StarryReverie/board/ppt/assets/下板终端日志.jpg

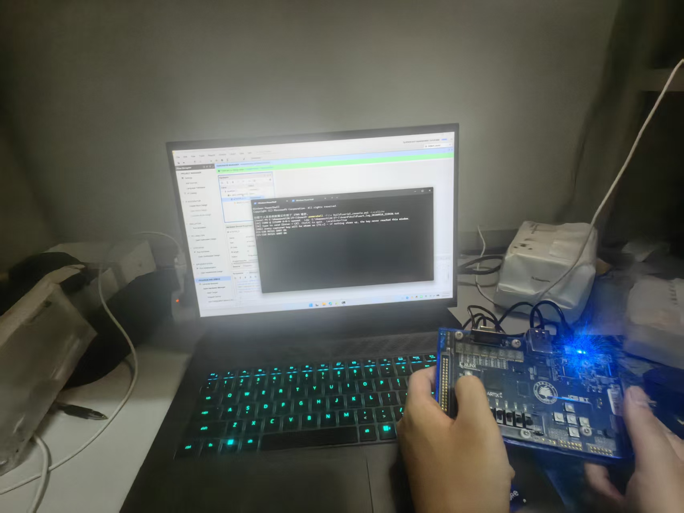
ppt/assets/下板终端日志.jpg
