StarryReverie/board/README.md

# board — 计算机组成原理 + 汇编与接口 课程设计

## 目录结构

```text
board/
 ├─ pipeline/            计组实验一（本仓主干，统一代码目录）
 │   ├─ src/rtl/          流水线 CPU core RTL（14 模块，含 pipeline_top）+ 上板顶层 exp1_board_top/exp1_reset_sync
 │   ├─ src/defines/      指令/常量宏
 │   ├─ src/test/         TB + 汇编测试程序（.asm/.hex + 上板固化镜像 _init.vh）
 │   ├─ src/scripts/      run_tb.ps1（批量仿真）、run_perf.ps1（性能测量）、build_asm.ps1（汇编→hex）、fix_encoding.ps1（编码校验）、synth_check.tcl（综合自检）、hex_to_vh.ps1（hex→固化镜像）、create_exp1_board_proj.tcl（上板工程）
 │   ├─ xdc/              实验一独立上板引脚约束（board_exp1.xdc）
 │   ├─ doc/              计组设计文档（isa/top_design/tasks/modules/future_extensions/perf_analysis 性能分析方案 v2.1/perf_report 实测数据/board_runbook 上板手册）
 │   └─ exp1_vivado.bat   exp1 Vivado 工程入口
 ├─ UART/                汇编与接口课程（交付物：UART 控制器 IP——uart_ip_top + 内部层 + IP 级独立测试）
 ├─ soc/                 整个项目的顶层（SoC 集成，两课共建：soc_top/reset_sync/dbus_decode + 固件/XDC/系统 TB）
 ├─ SUBMISSION.md        两门课提交物核对清单（9/18 24:00 截止）
 ├─ ref/CPU/             大三单周期参考工程（只读）
 └─ tools/(仓库外)        RISC-V 工具链（E:\Homework\26-27-1\tools）
```

## 快速上手（本机 Vivado 2019.2 + xPack RISC-V 工具链）

```powershell
# 仿真全部单测/回归（23 项，须在装有 Vivado 的机器）
powershell -File pipeline/src/scripts/run_tb.ps1          # 全部
powershell -File pipeline/src/scripts/run_tb.ps1 -Case alu # 按名过滤

# 汇编测试程序 → 机器码镜像
powershell -File pipeline/src/scripts/build_asm.ps1

# 性能测量（8 档程序：CPI/IPC/停顿分解，汇总 out/perf_summary.csv）
powershell -File pipeline/src/scripts/run_perf.ps1

# Vivado 综合自检（include 目录 = pipeline/src/）
vivado -mode batch -source pipeline/src/scripts/synth_check.tcl

# 文本编码健康校验（全仓 UTF-8；默认仅报告，-Apply 写回）
powershell -File pipeline/src/scripts/fix_encoding.ps1
```

## 实验一独立上板（CPU core 单独上板，不接 UART）

```powershell
# ① 汇编上板验收程序 → .hex
uv run --no-project --python 3.13.13 pipeline/src/scripts/simple_asm.py pipeline/src/test/exp1_board_demo.asm
# ② .hex → 综合固化镜像 <名>_init.vh（含回读逐字节校验）
powershell -File pipeline/src/scripts/hex_to_vh.ps1 -Hex pipeline/src/test/exp1_board_demo_rom.hex -PadBytes 512
# ③ 生成独立上板工程（pipeline/vivado/board_exp1.xpr，512B IMEM / 256B DMEM）
vivado -mode batch -source pipeline/src/scripts/create_exp1_board_proj.tcl
```

完整步骤（综合/烧录/验收判据/拍摄/故障定位）见 **`pipeline/doc/board_runbook.md`**；
板级顶层为 `exp1_board_top`（LED 状态灯 + 8 位数码管显示验收签名 `0000000F`），
引脚约束 `pipeline/xdc/board_exp1.xdc`（依 EES-338 用户手册 §6.3/§6.4）。

## 下板（SoC U32：本机已可全流程出 bit+烧录；完整方案见 soc/doc/board_runbook.md）

> 2026-09-15：SoC 建工程改为**一条命令**——`vivado -mode batch -source soc/scripts/create_soc_proj.tcl`（工程 `soc/vivado/soc.xpr`，bit 产物 `soc/vivado/soc.runs/impl_1/soc_top.bit`）；固件构建脚本保留 `UART/src/scripts/build_fw.ps1`（综合自检 `UART/src/scripts/synth_check.tcl`）；烧录/取证脚本仍为手动步骤或从 git 历史恢复。完整口径见 `soc/doc/board_runbook.md` §1（**part 必须用实测 `xc7a100tcsg324-1`**，用户手册误标 35T）。

# Vivado GUI（工程已按工程风格分组，可直接打开）
```text
双击 pipeline/vivado/board.xpr（exp1 工程，目录 = pipeline/vivado；若不存在，先执行下方重建命令）
  设计源 sources_1 : pipeline/src/rtl/*.v          top = pipeline_top（综合/实现）
  仿真源 sim_1     : pipeline/src/test/tb_*.v      top = tb_pipeline_top（默认）
  约束  constrs_1  : （实验一为空；SoC XDC 在 soc/xdc/board.xdc）
  include 目录     : pipeline/src/（VerilogDir=$PPRDIR/../src，`include "defines/…" 由此解析）
soc（SoC 集成）工程：`soc/scripts/create_soc_proj.tcl` 一条命令生成（见 soc/doc/board_runbook.md §1）；UART（UART IP）单独建工程时只需读入 UART/src/rtl/*.v，top=uart_ip_top（也可用 UART/src/scripts/synth_check.tcl 做不落盘的综合自检）。
```
重建工程（工程不入 git，本机生成即可）：
```powershell
vivado -mode batch -source pipeline/src/scripts/create_vivado_proj.tcl   # 实验一 流水线 CPU → pipeline/vivado/board.xpr
vivado -mode batch -source soc/scripts/create_soc_proj.tcl              # 实验二 SoC → soc/vivado/soc.xpr
```

辅助脚本（演示 / 验证，均在仓库内、产物落 `build/`）：
```powershell
# 实验二：串口终端（视频演示用；只打印 FPGA 回传的字节，等价 Local echo 关闭）
powershell -File soc/scripts/serial_console.ps1 -Log build\uart_soc_terminal_YYYYMMDD.log
powershell -File soc/scripts/run_soc_tb.ps1               # SoC/UART 侧 TB（3 项；-All 全跑）
# 实验一：逐拍 trace / 变异与 ALU 故障矩阵（证据脚本）
powershell -File pipeline/src/scripts/run_trace_bd.ps1
powershell -File pipeline/src/scripts/run_mut.ps1
powershell -File pipeline/src/scripts/run_mut_alu.ps1
```
用法与操作卡见 `soc/doc/board_runbook.md` §10 与 `pipeline/doc/board_runbook.md` §8。

> 说明：RTL 内 `` `include "defines/*.v"`` 以 **pipeline/src/ 为 include 目录**解析；Vivado
> 工程中把 include 目录指向 `pipeline/src/` 即可直接读入 `pipeline/src/rtl/` 全部源码。
> 程序级回归 TB（tb_prog_*）经 $readmemh 按文件名读 .hex，GUI 直跑需把
> `pipeline/src/test/*.hex` 复制到 xsim 工作目录；**推荐用 run_tb.ps1 跑仿真**（自动拷贝）。
