StarryReverie/board/pipeline/doc/top_design.md

# 计算机系统顶层设计（实验一：流水线 CPU core · 实验二：UART 集成 SoC）

- 版本：v1.7（2026-09-07：uart_ctrl 寄存器层并入 uart_ip_top——单模块 UART IP，功能/契约零改动；对齐 UART interface v1.3）。
- 布局：代码目录统一于 `pipeline/src/`（RTL `*.v` 于 `pipeline/src/rtl/`、宏 `pipeline/src/defines/`、汇编/测试 `pipeline/src/test/`、工具 `pipeline/src/scripts/`）；文档 `pipeline/doc/`；汇编实验独立于 `UART/`；`ref/CPU/` 不改动。指令集：`pipeline/doc/isa.md`（26 条 RV32I，统一编址 MMIO 不加指令）；参考：`pipeline/doc/ref_note.md`。

---

## 0. 项目两级结构、模块清单与分工

> 本文档覆盖两门课程设计：**实验一**＝RV32I 5 级流水线 **CPU core**（`pipeline_top`，§1–§8，门禁 M1–M3，见 tasks.md §2–§5）；**实验二**＝在其上集成全双工 UART 形成**整机 SoC**（§9，见 tasks.md §6 T40–T44）。实验一单独交付时 core 的 `dbus_decode` 与 `imem` 写口不启用（恒 0/不例化），§1–§8 完全成立。

### 0.1 两级结构（总图）

```
【实验一】CPU core = pipeline_top（§1–§8，交付物）
   取指 IF ──► 译码 ID ──► 执行 EX ──► 访存 MEM ──► 回写 WB ──► regfile
   段间寄存器：if_id · id_ex · ex_mem · mem_wb（各带 en/flush）；冒险：hazard_unit 前递/冻结/冲刷

   实验一存储接法 = 直连（无译码、无写口）：
     取指侧  pc ──► imem 读口 ──► inst ──► IF/ID
     访存侧  ex_mem ──► dmem ──► mem_wb        （取指/访存分体 → 哈佛，互不冲突）

【实验二】SoC 整机 = soc_top（§9）＝ 实验一 core ＋ 数据侧统一编址译码 ＋ UART 外围（程序固化模型）
   ① 取指侧：程序 .vh 初值固化于 imem，上电自跑 0x0（每次启动执行同一程序）；imem 写口为预留（恒 0）
     运行：   pc ──► imem(读口) ──► inst ──► IF/ID          ← core 取指（固定程序）
     换程序： 重新生成 .vh → 重新综合 → 重烧 .bit（JTAG/SPI-Flash）；不做运行期在线重载（loader 搁置）

   ② 访存侧：MEM 段插 dbus_decode 选路 —— CPU 不再直连 dmem/uart（统一编址 MMIO，方案 B：lw=读 in/r、sw=写 out/w）
     ex_mem(addr/wdata/we) ──► dbus_decode ──┬─ 低区 cs_dmem ──► dmem 数据 RAM
                                              └─ MMIO cs_mmio ──► uart_ip_top（TX/STAT/RX 字槽）
     读回：  mem_wb ◄── rdata ◄── dbus_decode（dmem/uart 二选一 mux）
     外发：  uart_ip_top（寄存器层 + uart_tx/uart_rx，全双工）──► USB-UART ──► PC

   复位（§9.5）：板载复位键 ──► reset_sync ──► rst(异步高有效) ──► core（单时钟域 clk）
```

- **实验一（core）**：上图的"CPU core"即 `pipeline_top`＝5 段哈佛流水，交付可综合 CPU core，H1–H5 全绿（门禁 M1–M3，tasks.md §2–§5）。
- **实验二（SoC）**：`soc_top`＝`pipeline_top`（数据侧含 `dbus_decode` 统一编址译码）＋ `uart_ip_top`（实验二 UART 控制器 **IP 顶层**，寄存器层已并入，单模块交付）＋ `reset_sync`（上板复位）。程序经 `.vh` 固化于 imem：上电自跑固定固件 console（§9.6，banner+回显）；换程序＝重新生成 `.vh` → 重新综合 → 重烧（§9.3）。

### 0.2 模块清单（RTL 归属 ↔ 文档）

| 归属 | 模块 | 段/角色 | 模块文档 |
|---|---|---|---|
| 实验一 | `pc_reg` / `imem` | IF：取指/指令存储 | modules/{pc_reg,imem}.md |
| 实验一 | `if_id` / `decode`+`regfile` / `id_ex` | ID | modules/{if_id,decode,regfile,id_ex}.md |
| 实验一 | `execute`（含 `alu`） | EX | modules/{execute,alu}.md |
| 实验一 | `ex_mem` / `dmem` / `mem_wb` / `wb` | MEM/WB | modules/{ex_mem,dmem,mem_wb,wb}.md |
| 实验一 | `hazard_unit` / `pipeline_top` | 冒险 / 装配 | modules/{hazard_unit,pipeline_top}.md |
| 实验二 | `dbus_decode` | core 数据侧译码（统一编址，入 pipeline_top MEM 段） | modules/dbus_decode.md |
| 实验二 | `uart_ip_top` | UART 控制器 **IP 顶层**（实验二交付物；寄存器层已并入，内部例化 `uart_tx`/`uart_rx`） | [uart_ip_top.md](../../UART/doc/modules/uart_ip_top.md) |
| 实验二 | `loader`（**搁置**） | imem 引导装载（固化单程序模型下不做；恢复条件见 future_extensions §1/§2） | 实验二登记（取消） |
| 项目顶层（soc/） | `soc_top`（含 `reset_sync`） | 整机例化 / 复位同步 | [soc_top.md](../../soc/doc/modules/soc_top.md) |

---

## 1. 总体结构：5 段 × (组合逻辑 + 段间寄存器)

一条指令沿 5 级流过，每级 = 一段组合逻辑，段间由寄存器锁存结果（§0.1 总图中的 CPU core）：

```
 取指 ─► if_id ─► 译码 ─► id_ex ─► 执行 ─► ex_mem ─► 访存 ─► mem_wb ─► 回写
  IF               ID               EX               MEM               WB
```

| 段 | 组合逻辑 | 边界寄存器（本段结束沿锁存） |
|---|---|---|
| IF 取指 | `pc_reg`、`imem`（组合读） | `if_id` |
| ID 译码 | `decode` + `regfile`（读口） | `id_ex` |
| EX 执行 | `execute`（含 `alu`、分支目标加法） | `ex_mem` |
| MEM 访存 | `dmem`（组合读/同步写） | `mem_wb` |
| WB 回写 | `wb`（选 rdata/alu 回写） | —（写回 `regfile`） |

- 段间 4 组边界寄存器由 `hazard_unit` 统一驱动：前递 `fwd_a/b_sel`、load-use 冻结 `stall`、分支冲刷 `flush`（策略见 §4）。
- 哈佛：IMEM（指令）与 DMEM（数据）物理分离 → 结构冒险靠分离化解（报告口径）。
- 模块互连信号全表见 §5；实验二在 MEM 段数据侧插入 `dbus_decode`（统一编址 MMIO，§9.2）；程序 `.vh` 固化于 imem、写口预留（§9.3）。

## 2. 段间寄存器边界与字段（字段名即跨模块信号名）

| 寄存器 | 位置 | 字段 | 说明 |
|---|---|---|---|
| if_id | IF/ID 间 | `ifid_inst[31:0]`, `ifid_pc[31:0]` | 冻结：`en=0`；冲刷：置 NOP `0x13` |
| id_ex | ID/EX 间 | `idex_pc, idex_rs1_data, idex_rs2_data, idex_imm, idex_rs1, idex_rs2, idex_rd`；`ctrl`：`alu_op[3:0], src_a[1:0], src_b[1:0], mem_read, mem_write, mem_to_reg, reg_write, jump[1:0], bne` | 冲刷/气泡：`ctrl` 全 0（NOP） |
| ex_mem | EX/MEM 间 | `exmem_alu_result, exmem_wdata, exmem_rd`；`mem_read, mem_write, mem_to_reg, reg_write` | 常规打入 |
| mem_wb | MEM/WB 间 | `memwb_rdata, memwb_alu_result, memwb_rd`；`mem_to_reg, reg_write` | 常规打入 |

控制组说明：
- `alu_op[3:0]`=`ALU_*`（`const_define.v`）；`jump[1:0]`=`0`无/`1`分支/`2`jal/`3`jalr；`bne`=1 表示 bne。
- `src_a[1:0]`：A 源 `0=rs1_fwd/1=idex_pc/2=0`；`src_b[1:0]`：B 源 `0=rs2_fwd/1=imm/2=4`。
- 组合约定：LUI=`src_a=0,src_b=imm,op=OR`(0|imm 直通)；jal/jalr 链接=`pc+4` 写 rd。
- 译码真值表见 `modules/decode.md`；字段全表见各模块文档。

## 3. 取指 / 分支 / 跳转语义（EX 段判决）

| 指令类 | ALU | ALU 结果用途 | 目标 | 条件 |
|---|---|---|---|---|
| beq/bne | src_a=rs1, src_b=rs2, op=SUB | 置 `zero` | `target = pc + imm`（专用加法器，A 选 pc） | taken = `bne? !zero : zero` |
| jal | src_a=pc, src_b=4, op=ADD | 链接 `pc+4` 写 rd | `target = pc + imm`（加法器，A 选 pc） | 恒 taken |
| jalr | src_a=pc, src_b=4, op=ADD | 链接 `pc+4` 写 rd | `target = rs1_fwd + imm`（加法器，A 选 rs1_fwd） | 恒 taken |
| lui | src_a=0, src_b=imm, op=OR | imm 直通写 rd | — | — |
| 普通 ALU | src_a=rs1 | 常规 | — | — |

- 目标加法器：A=`jump==3 ? rs1_fwd : pc`，B=`imm`；`br_target = A+B`（jalr 结果 &~1）。
- **控制冒险**：not-taken 预测。taken → 下一沿冲刷 2 条（IF/ID 置 NOP、ID/EX 控制清零）且 PC←br_target；not-taken 无气泡；EX 指令正常流入 EX/MEM。分支比较值由前递/旁路提供（§5），故仅在真正的 load-use 距离才停 1 拍。

## 4. 冲突（冒险）处理策略 —— hazard_unit

| 冲突 | 手段 | 条件（判定） | 代价 |
|---|---|---|---|
| 数据相关（RAW） | **前递** EX/MEM 与 MEM/WB → EX 的 A/B 源 | EX/MEM 或 MEM/WB 指令 `reg_write && rd≠0` 且 `rd==EX 的 rs1/rs2 地址`；**EX/MEM 为 load(`mem_read`)时不前递**（数据未就绪，靠下方 stall） | 0 |
| load-use | **冻结**：PC 与 IF/ID 停一拍，ID/EX 灌气泡 | ID 指令 rs1/rs2 命中 `idex` 中 load(`mem_read=1`) 的 `rd`（rd≠0） | 恰 1 气泡 |
| 控制相关 | 分支 EX 判决 + taken 冲刷 2 条（§3） | EX 段 taken | 恰 2 条 |
| 结构相关 | IMEM/DMEM 分离 + regfile 2 读 1 写 | 设计上消除 | 0 |

- 前递优先级：EX/MEM（更近）优先，同命中取 EX/MEM；MEM/WB 前递值 = `mem_to_reg ? rdata : alu_result`（已含 jal 链接值）。
- regfile **读旁路（write-first）**：读口命中当拍写口且 `reg_write` 时返回 `wdata`，消除"生产者恰在 WB、消费者同拍在 ID"的陈旧读。
- 控制输出（hazard_unit → 各段）：`fwd_a_sel/fwd_b_sel[1:0]`（`0=reg 1=EX/MEM 2=MEM/WB` → execute）；`stall`（load-use → `pc_reg.en=0, if_id.en=0, id_ex 气泡`）；`flush_branch`（=EX `br_taken` → if_id 冲刷、id_ex 气泡，`pc_src=1`）。
- 冻结与冲刷互斥：EX 段单指令不可能同时是 load 与分支。

## 5. 数据通路信号总览（模块互连）

| 段 | 模块 | 输入（来源） | 输出（去向） |
|---|---|---|---|
| IF | `pc_reg` | clk/rst, en, pc_src, pc_branch(EX) | pc → imem 地址（组合输入）、if_id 的 pc 位 |
| IF | `imem` | 地址=pc（读口） | inst → if_id（.vh 固化；写口预留恒 0，§9.3） |
| ID | `if_id` | en, flush, pc, inst | ifid_pc, ifid_inst → decode |
| ID | `decode`+`regfile` | ifid_inst/ifid_pc, regfile 写回, `idex_mem_read/idex_rd`(load-use) | rs1_data/rs2_data/imm/rd/Ctrl → id_ex |
| EX | `id_ex` | decode 全部输出 + flush/气泡 | → execute、hazard_unit |
| EX | `execute`(alu+目标加法) | idex_*, fwd_a/fwd_b 源值 | alu_result/zero, wdata(rs2_fwd), br_taken/br_target → ex_mem、pc_reg、hazard_unit |
| MEM | `ex_mem` | execute 输出 | → dmem、mem_wb |
| MEM | `dmem` | 地址=exmem_alu_result, wdata=exmem_wdata, we | rdata → mem_wb（实验二经 dbus_decode 选路，§9.2） |
| WB | `mem_wb` | dmem rdata + ex_mem 输出 | → wb |
| WB | `wb` | memwb_* | regfile 写口（经 wb 选路） |

## 6. 存储（Verilog 口径，面向下板）

- `imem`（指令存储）：读口=取指**组合读**；内容在综合期由 `.vh`（`initial` 字面量 `for` 循环）**固化**——上电不接任何装载动作即可直接运行（`pipeline/src/test/*.hex` 仅供 TB `$readmemh`，两路一致性由校验脚本保证）；**loader 写口为预留**（`imem_wen/imem_waddr/imem_wdata`，字 4 对齐同步写，实验一/实验二均恒 0；若未来恢复"运行期换程序"须先回写本文件与 tasks.md，见 future_extensions §1/§2）。字节数组小端 `{mem[a+3],…,mem[a]}`，字地址 4 对齐。
- `dmem`：同步写（wmask 字节使能，默认全字）、组合读（周期内稳定）；字节数组小端。
- 规模：`IMEM_WORDS/DMEM_WORDS`（默认各 1024 字=4KB，测试集 <1KB），综合为分布式 ROM/RAM；块 BRAM 为可选优化（读出寄存器另计一拍）。
- `.vh`/`.hex` 一致且仅含指令清单内指令，由 `verify_hex.py` 校验（tasks.md T31）。

## 7. 时钟/复位

- 单时钟 `clk`；复位 `rst` **异步高有效**（对齐参考 `pc_reg.v/regfile.v` 的 `posedge rst` 写法）：复位 PC=0、流水寄存器与 regfile 清零。每模块单时钟、无门控；段间寄存器 `en/flush` 由 hazard_unit 统一驱动。

## 8. 验收口径（H1–H5）

- H1 直行无依赖链：CPI=1（首条启动流水外），cycle 数=手算。
- H2 前递：`add x1,..;` 紧接用 x1 无气泡，终值=golden。
- H3 load-use：`lw x2,0(x1); add x3,x2,x2` 恰 1 气泡。
- H4 分支：taken 刷 2 条 / not-taken 无气泡，cycle 与手算一致。
- H5 整程序（test0/test1/sort + 新增）与注释预期一致。

## 9. 实验二：SoC 集成设计（整机 = core + dbus_decode + uart_ip_top，程序固化）

> 本节把实验一交付的 CPU core（§1–§8，门禁 M1–M3 全绿后启动）构造成**能与 PC 通信的整机**：数据侧插入 `dbus_decode`（统一编址 MMIO，§9.2）、程序经 `.vh` 固化于 imem 自启动（固化单程序模型，§9.3）、全双工 UART 外设与整机装配（§9.4/§9.5）、固定固件 console（§9.6）、验收（§9.7）。任务见 tasks.md §6（T40–T44）。core 本身不因实验二改动：imem 写口/MMIO 译码实验一恒 0/不例化，H1–H5 口径不变。

### 9.1 架构口径（一句话）

- 执行期**哈佛不变**：IF 直连 `imem` 读口，数据 `lw/sw` 走 MEM 段数据总线。**程序固化模型**：程序镜像在综合期经 `.vh` 初值写入 `imem`，上电复位后 CPU 恒从 `0x0000_0000` 执行同一程序；换程序 = 重新生成 `.vh` → 重新综合 → 重烧 `.bit`（JTAG 下载易失 / SPI-Flash 上电自启）；**不做运行期在线重载**（loader 状态机搁置，见 future_extensions §1/§2）。运行期 `imem` 只读（预留写口恒 0）→ 仍是哈佛（改良哈佛），不是冯·诺依曼。

### 9.2 数据侧译码（dbus_decode：DMEM/MMIO 选路）

- 独立组合模块 **`dbus_decode`**（数据总线译码，模块文档 `pipeline/doc/modules/dbus_decode.md`）。插入位置：`ex_mem` 与 `mem_wb` 之间（实验一 dmem 直连处）。按 `addr=exmem_alu_result` 选从设备并出 `cs_dmem/cs_mmio/reg_off`，回写数据 `rdata` mux。实验一不例化；T40 启用并接 dmem/uart_ip_top。
- 时序对齐：外设读与 dmem 同为周期内组合（沿前稳定）、写与 dmem 同步写同一沿 → 插入译码**不引入新冒险、不改流水级数**。与 hazard 无关（load-use/前递按 rd 判定，不关心命中 RAM 还是外设）。
- 地址映射（**定稿 v1.4；同步冻结于 `isa.md` §4**）：

| 数据地址 | 目标 | 说明 |
|---|---|---|
| `0x0000_0000`–`0x0000_0FFF`（`addr < DMEM_BYTES`，默认 4096） | `dmem` | 数据 RAM（lw/sw） |
| MMIO 窗口 `0x0000_4000`：+0x0 | TX 槽 | 写=待发字节（低 8 位；TX_BUSY=0 时触发发送，忙时写丢弃）；读=0 |
| +0x4 | STAT 槽 | 读：bit0=TX_BUSY、bit1=RX_VALID；写无操作 |
| +0x8 | RX 槽 | 读=收到字节（低 8 位），读后清 RX_VALID；写无操作 |
| 其余 | — | `rdata=0`、写丢弃（程序不应访问，无定义但无害） |

- 编址口径（方案 B 定稿）：**统一编址，不加 in/out 指令**——`lw` 即外设读（in/r）、`sw` 即外设写（out/w），读写方向由指令天然区分；低区/MMIO 窗口由 `addr` 判定，`reg_off[1:0]` 拆槽（00=TX、01=STAT、10=RX、11=保留）。上表即程序可见内存映射。

### 9.3 程序固化与换程序流程（固化单程序模型）

- **固化**：imem 内容 = `verify_hex.py` 生成的 `.vh`（`initial` 字面量，综合装载）；上电复位 PC=0 直接运行固化程序，无需任何装载动作；仿真侧由 TB `$readmemh` 装载同内容 `.hex`（两路一致性由校验脚本保证）。
- **换程序**：改 `pipeline/src/test/*.asm` → `make` 出 `.hex/.vh` → 重新综合 → 重烧 `.bit`（JTAG 下载（易失）或 SPI-Flash（上电自启））；演示"换程序"即重烧流程（可选，§9.7）。**不做运行期在线重载**。
- imem loader 写口（`imem_wen/imem_waddr/imem_wdata`）保留为**预留**（恒 0，无附加逻辑）；若未来恢复在线重载，须先回写本文件与 tasks.md，并遵守"写窗口=CPU 复位期、不得边取指边写"（loader=独立硬件 FSM，不执行指令，见 future_extensions §1/§2）。

### 9.4 MMIO 外设：uart_ip_top（全双工 UART 接口控制器 IP）

- 地位：**实验二交付物——基础任务 UART 控制器 IP 的顶层**（`UART/src/rtl/uart_ip_top.v`），作 dbus_decode 的 MMIO 从机；IP 自含槽译码（addr[3:2]→TX/STAT/RX），soc_top 内以 `addr={reg_off,2'b00}` 接入；寄存器层（原 `uart_ctrl`：分频/TX 挂起/RX 寄存器/位义）已并入本模块，与例化的 `uart_tx`/`uart_rx` 一体交付。**全双工**：两路独立工作，8N1@115200（板载 100 MHz，`clk_en` 分频 868，位误差 ≈0.0064%）。字槽访问用 `sw`/`lw` 即可，无需 sb/lbu。
- 寄存器映射（定稿，见 §9.2 表）：TX 槽（`sw` 写=发送）、STAT 槽（`lw` 读：bit0=TX_BUSY（1=发送忙：挂起待发或移位中）、bit1=RX_VALID（1=有未读字节））、RX 槽（`lw` 读=字节，读后清 RX_VALID）。
- 收发语义：写 TX 仅在完全空闲（TX_BUSY=0，无挂起无移位）时有效，挂起/忙时写入丢弃（软件轮询保证不丢）；收到完整字节置 RX_VALID；**无 FIFO**：RX_VALID 未清期间到达的新字节丢弃；读 RX 在访存段末沿清 RX_VALID。
- 时序：字槽访问在 MEM 段一拍完成（组合读/末沿写），不卡流水、无 wait——**波特率远慢于 CPU**，固件连发多字节须轮询 TX_BUSY，收侧由 RX_VALID 回馈轮询。`uart_rx` 输入打两拍防亚稳态。
- 实现组成：`uart_tx`（8N1 发送 FSM）、`uart_rx`（起始位检测 + 位中心采样 + 停止位校验的接收 FSM）、寄存器与位义逻辑；收发同频同参，分频参数仿真可覆盖（tasks.md §6 T41）。

### 9.5 整机装配：soc_top（顶层 + 复位 + 引脚）

- `soc_top`（整个项目的顶层，代码在 `soc/`）例化三个平级实例 + 复位同步：
  - `pipeline_top`（core）：内部含 `dbus_decode`（§9.2，MEM 段）；
  - `uart_ip_top`：全双工 UART IP 顶层（§9.4），由 dbus_decode 的 mmio 总线驱动；
  - `reset_sync`：复位同步（见下）。
- mmio 总线穿出 core：`cs_mmio/reg_off/mmio_we/mmio_wdata`（pipeline_top → uart_ip_top，soc_top 内适配 `addr={reg_off,2'b00}`）、`mmio_rdata`（uart_ip_top → pipeline_top → dbus_decode 的 rdata mux）——core 增加一组**外设总线端口**（实验一未用即悬空/接 0，H1–H5 不受影响）。示意：

```
 soc_top（整个项目的顶层，soc/ 装配）
 │
 ├─ reset_sync ：rst_n(键) ──(异步置位/同步释放)──► rst(异步高有效) ──► core
 │
 ├─ pipeline_top（=core，§1–§8，dbus_decode 内置于 MEM 段）
 │     IF : pc_reg ─► imem（.vh 固化程序；loader 写口预留恒 0，§9.3）
 │     MEM: ex_mem ─► dbus_decode ─┬─► dmem（低区）
 │                                └─► MMIO 总线(cs_mmio/reg_off/mmio_we/mmio_wdata，穿出 core)
 │                                     ──► uart_ip_top（addr={reg_off,2'b00}），读回 mmio_rdata ──► rdata mux
 │
 └─ uart_ip_top（UART 控制器 IP 顶层，§9.4）
       ── uart_tx / uart_rx（打拍）──► 板载 USB-UART 引脚（T4 / N5）
```

- 时钟：整机**单时钟域** `clk`（板载晶振 100 MHz）；uart 波特率由 `clk_en` 分频产生，无第二时钟域、无异步跨域（rx 输入仅打两拍防亚稳态，与收发时序无关）。
- 复位：板上按键 `rst_n`（低有效）→ `reset_sync`（异步置位、同步释放，2 级同步器）→ core 语义的 `rst`（异步高有效，对齐 §7）。复位=程序从头重跑（imem 内容不变；dmem 不复位 → 程序须自初始化数据区）。
- 引脚（XDC 定稿，EES-338 用户手册）：晶振 `clk`=T5（100 MHz）、`rst_n`=FPGA_RESET/P15（极性以 demo XDC 为准）、`uart_tx`=T4、`uart_rx`=N5（原理图网络名 UART_RX/UART_TX 以 CP2102 视角命名，方向以 FPGA 为准）、板载 LED（运行/状态指示，可选）。

### 9.6 固件与程序模型

- 内存映射（程序可见视角）：取指=`imem`（哈佛，`.vh` 固化只读）；数据=`dmem` 低区 + MMIO 窗口 `0x4000`（§9.2 表）；外设读写 = 普通 `lw`(in/r)/`sw`(out/w)。
- **固定固件（console）**：上电自跑 `.vh` 初值：初始化 → 打印 banner（轮询 TX_BUSY 逐字符发送）→ 回显循环（轮询 RX_VALID，读 RX 收到即回发；可加简单命令如帮助）。**无 reload 命令**（换程序=重新综合烧录，§9.3）。
- 字符串处理（无 auipc/lb）：banner 常量以 `lui+addi` 现场拼装逐字符发送，或按"字内低 8 位一字符"由程序启动时 `sw` 自初始化进 dmem 数据区再 `lw` 读出（演示程序两者择一，T42 定稿）；**dmem 不复位 → 数据区每次启动须自初始化**。
- 程序模型：整个实验二只烧录**一个固化程序**（console 回显）；如需更换演示内容，重新生成 `.vh` → 综合 → 烧录。

### 9.7 实验二验收

- 仿真（系统级 TB，T43）：行为级 UART 模型（收/发双向）回环 CPU；断言 banner 字节序列正确、键盘回显往返一致、复位后重跑一致。
- 下板（T44）：综合/实现时序收敛 → 上板经 USB-UART（PC 串口终端 115200-8-N-1）观察 banner；键盘输入逐字回显；按键复位重跑；换程序=重烧 `.bit`（可选演示）。
- 门禁：自 M1–M3 全绿后进入（tasks.md §6）。

## 10. 变更记录

- v1.7 2026-09-07：uart_ctrl 寄存器层并入 uart_ip_top（单模块 UART IP：删 exp2/src/rtl/uart_ctrl.v；§0.2/§9.4 称谓同步，功能/契约零改动）。
- v1.6 2026-09-07：实验二交付物收敛为独立 UART IP（`uart_ip_top`，exp2/）——SoC 上移为整个项目的顶层 `soc/`（soc_top/reset_sync/dbus_decode 代码随迁）；§0.2/§9.2/§9.4/§9.5 从机称谓与装配图同步（契约信号不变，soc_top 内适配 `addr={reg_off,2'b00}`）。
- v1.5 2026-09-06：TX_BUSY 位义修正——STAT bit0=1 表示发送忙（含挂起待发与移位中）；uart_ctrl 写接受仅限完全空闲（挂起期写丢弃），消除连续 putc 的"挂起窗口"丢字隐患（同步 isa v1.4 / exp2 interface v1.1）。
- v1.4 2026-09-04：实验二模型定稿——统一编址 MMIO（方案 B：不加 in/out，`lw`=in/r、`sw`=out/w）、UART 全双工与 TX/STAT/RX 槽位义定稿、程序固化单程序模型（loader 在线重载搁置：§9.1/§9.3 改写、§9.5 soc_top 去 loader、§9.6 固件无 reload、§9.7 验收改回显交互；引脚按 EES-338 手册定稿 T5/T4/N5/P15）。
- v1.3 2026-09-04：文档升级为**两课设一体**顶层设计：新增 §0（两级结构/模块清单，§1–§8=实验一 core，§9=实验二 SoC）；§9 由"集成预留"扩写为实验二整机设计（soc_top/uart_ctrl/loader/reset_sync/固件/验收 §9.2–§9.7）；标题改"计算机系统顶层设计"。
- v1.2 2026-09-04：新增 §9 集成预留（数据侧 MMIO + 指令在线重载）；指令存储按"带初值 + loader 写口"描述（`imem_rom`→`imem`）。
- v1.1 2026-09-04：行文精简。
- v1.0 2026-09-02：初稿。
