StarryReverie/board/soc/doc/board_runbook.md

# 下板实验方案（其他设备执行）—— EES-338 + UART SoC console

- 版本：v1.6（2026-09-16：§9 见变更记录——PR #13 review 加固：`reset_sync` 释放路径全同步化、脚本防死锁/退出码、`serial_console.ps1` 回车换行改由 FPGA 回显 CR 触发、USB-UART 桥描述统一）。v1.4 起 §1 为**一条命令建工程**（`soc/scripts/create_soc_proj.tcl`，落点 `soc/vivado/soc.xpr`）、器件型号为实测 `xc7a100tcsg324-1`；固件构建脚本保留 `UART/src/scripts/build_fw.ps1`，烧录/取证脚本为手动步骤或从 git 历史恢复。
- 目标：在**任意一台装好 Vivado 的机器**上独立完成 U32 下板：出 bit → 烧录 → 终端验收（banner/回显/复位重跑）→ 证据采集。
- 验收判据与分层流程以 `../../UART/doc/tasks.md` §3（U32/U30）为准；本文只讲"怎么在别的设备跑通"，假设仓库完整（固件 .vh 已生成，无需 RISC-V 工具链）。

---

## 0. 设备与前置清单

| 项 | 要求 |
|---|---|
| Vivado 主机 | 任意 Windows/Linux + **Vivado 2019.2 或更新**（Artix-7 WebPACK 免费版即可）；若在"本机"执行请先读已知限制（下 §7） |
| EES-338 | 一块；USB 线 ×2：**Type-C USB-UART**（兼供电；本机实物板载桥实测为 **FTDI VID_0403/PID_6010**，手册标 CP2102——**以设备管理器实测为准**，见 §4）与 **Type-C/方口 USB-JTAG**（依板型，两接口功能不同） |
| 串口终端 | Tera Term / SSCOM（演示视频用）；自动化取证脚本已删（§4.4） |
| 示波器 | （证据可选）测 FPGA uart_tx 引脚（T4）波形 |

## 1. 获取仓库与建工程（一条命令，~1 分钟）

```powershell
git clone https://github.com/StarryReverie/board.git
cd board

# 建工程：soc/vivado/soc.xpr（sources/sim/constrs/include/defines 全部口径已设好）
vivado -mode batch -source soc/scripts/create_soc_proj.tcl
```

脚本 `soc/scripts/create_soc_proj.tcl` 按下列口径建好工程（**只建工程，不综合**）：

| 项 | 值 |
|---|---|
| part | **`xc7a100tcsg324-1`** —— EES-338 实物 idcode 实测为 XC7A100T；**用户手册误标 35T，务必用实测值**，否则生成的 bit 烧不进实物 |
| sources_1 | `UART/src/rtl/*.v` + `pipeline/src/rtl/*.v` + `soc/rtl/*.v`（原位引用），top = `soc_top` |
| sim_1 | `UART/src/test/tb_*.v` + `soc/test/tb_*.v`，默认 top = `tb_soc_full`（不参与综合） |
| include | `UART/src`、`pipeline/src`（计组 `` `include "defines/*.v"`` 由此解析）、`soc/vivado/soc_build`（固件 ROM） |
| define | `IMEM_INIT_VH IMEM_WORDS=128 DMEM_WORDS=64 IMEM_BYTES=512 DMEM_BYTES=256`（下板缩容 512 B/256 B） |
| constrs_1 | `soc/xdc/board.xdc`（T5 clk 100 MHz / T4 uart_tx / N5 uart_rx / P15 rst_n） |

工程建好后在 GUI 里 `Run Synthesis` → `Run Implementation` → `Generate Bitstream`（约 5–15 分钟），
产物 `board/soc/vivado/soc.runs/impl_1/soc_top.bit`。

<details>
<summary>手动建工程（等价步骤，脚本不可用时备用）</summary>

1. 新建工程：`create_project soc soc/vivado -part xc7a100tcsg324-1`（**不是 35T**）；
2. 读入 RTL（原位引用）：`soc/rtl/*.v` + `UART/src/rtl/*.v`（UART IP）+ `pipeline/src/rtl/*.v`（计组 core）；top = `soc_top`；
3. include 目录设 `UART/src`、`pipeline/src`、`soc/vivado/soc_build`；
4. 固件固化：把 `soc/test/console_init.vh` 复制为 `soc/vivado/soc_build/imem_init.vh`（`imem.v` 硬编码 include 名），
   并设 `verilog_define` 为上表那一串；要重生成固件先跑 `powershell -File UART/src/scripts/build_fw.ps1`
   （`soc/test/console.S` → `console_rom.hex` + 补零到 512 B 的 `console_init.vh`，见 firmware.md §6）再复制；
5. 加约束 `soc/xdc/board.xdc`（T5 clk 100MHz / T4 uart_tx / N5 uart_rx / P15 rst_n）；
6. synth → impl → write_bitstream（约 5–15 分钟）。

</details>

- 无网络时：把仓库目录整体拷贝到目标机（`soc/`、`UART/src/rtl/`、`pipeline/src/rtl/` 即可，`vivado/` 可省）。
- 说明：仓库已内置 console 固件（`console_init.vh` → 综合期固化 IMEM），XDC 已按手册核定（T5=100MHz / T4=FPGA TX / N5=FPGA RX / P15=复位）。
- 变更：2026-09-15 起本节由"手动 6 步"改为"一条命令"——脚本从 `UART/src/scripts/create_vivado_proj.tcl`
  迁移为 `soc/scripts/create_soc_proj.tcl`，工程落点由 `UART/vivado/exp2.xpr` 统一为 `soc/vivado/soc.xpr`（口径不变）。

## 2. 烧录（~1 分钟）

**GUI 方式**：Vivado → Open Hardware Manager → Open target（自动连 localhost）→ Program Device → 选 `soc_top.bit` → Program。板载 D24（配置成功灯）应点亮。

**批处理方式（脚本已删）**：GUI Hardware Manager 操作，或用 Vivado Tcl Console 逐条执行 `open_hw_manager → connect_hw_server → open_hw_target → current_hw_device [lindex [get_hw_devices] 0] → set_property PROGRAM.FILE <bit> [current_hw_device] → program_hw_devices [current_hw_device]`。（找不到板时 `get_hw_devices` 为空——检查 USB-JTAG 线与驱动。）

## 3. 复位极性首测（第 0 步）

**已实测确认（2026-09-14，实验一独立上板，同一块 EES-338）**：P15 **低有效**——松键=运行、按下=复位，
与本设计默认一致，**无需反相**；同时实测两条板级坑：**丝印 `RESET(P9)` 的复位键实际接 FPGA P15**
（丝印括号里的引脚号不可信），而 **`PROG` 才是 P9 = `PROGRAM_B`，一按就擦配置**（板子随后从 SPI Flash
加载别的设计，现象是全灭/异常图案）——**切勿按 PROG**。

- 上电松键：应见 banner（若极性相反则 CPU 一直处于复位，无输出）。
- **松开后 core 不会立刻启动**：`reset_sync` 要求 `rst_n` **连续稳定 20 ms** 才释放（释放去抖，防按键抖动；
  见 §9 v1.5）→ banner 在**松手后约 20 ms** 才出现，属正常，不必以为"没反应"。
- **fallback（一般不再需要）**：若在别的板子上实测为"按下才运行/上电卡死"，把 `soc/rtl/soc_top.v`
  顶部参数 `RST_ACTIVE_LOW` 默认值 1 改 0 → 重跑 §1 步骤 → 重烧。（或经工程 `generic` 属性
  `RST_ACTIVE_LOW=0` 覆盖，等价。）

## 4. 终端验收（分三小步）

串口设置：**115200-8-N-1**；COM 号在设备管理器里找 —— 本机实物板载桥为 **FTDI（VID_0403 / PID_6010）**，枚举为 **"USB Serial Port (COM8)"**（手册写 CP2102，**以实测为准**；与本文曾记的"本机曾见 COM8"一致）。注意旁边那几个 **"蓝牙链接上的标准串行 (COM3/4/5/6)" 不是板子**，别选错。

1. **Banner**：上电/复位后终端应收到（精确文本）：
   ```
   EES-338 RV32I UART OK
   ```
   （即 23 字节 `45 45 53 2D 33 33 38 20 52 56 33 32 49 20 55 41 52 54 20 4F 4B 0D 0A`）
2. **回显**：键盘逐字输入，每个字符应即时回显（getc→putc 轮询往返）；连续快速输入不掉字（TX_BUSY 含挂起语义保证）。
3. **复位重跑**：按 P15（或 FPGA 复位键）→ banner 重新完整出现；重复 ≥2 次一致。
4. **自动化取证（脚本已删）**：原 uart_check.ps1（自动收 banner 比对 23 字节、发 `AB` 验证回显、写证据日志）已随结构调整删除，可从 git 历史恢复；手动等价=终端日志存档 + 肉眼比对 §4.1 字节序列。

## 5. 证据采集清单（提交物 U32 需要）

| 证据 | 要求 | 备注 |
|---|---|---|
| 终端日志 | Tera Term/SSCOM 存档：banner + 回显 + 复位重跑全过程 | 存 `soc/doc/board_evidence/` 建议 |
| 下板记录 | 按 `../../UART/doc/tasks.md` §3.1 分层记录（裸 UART 先行→SoC 整机） | 模板字段：日期/机器/COM/现象/结论 |
| 示波器波形（可选但加分） | TX 帧：空闲高、起始低、位宽 ≈8.68 µs、10 位帧 ≈86.8 µs | 测 T4（FPGA uart_tx）；桥侧同理，本机为 FTDI（手册标 CP2102） |
| ≤5 min 演示视频 | 全程：上电 banner→键盘回显→复位重跑 | 需真实板卡画面 |

## 6. 演示视频拍摄方案（≤5 分钟）

本节用于 U32 实验二 SoC 下板视频，须与实验一独立上板视频分开拍摄、命名和归档。建议成片 2–4 分钟，最长不得超过 5 分钟；画面需同时包含真实开发板和 PC 串口终端，避免只录屏或只拍板卡。

### 6.1 拍摄目标与画面要求

- 证明 `soc_top` 已由实验一 `pipeline_top`、UART IP 和复位同步模块组成，并在 EES-338 上运行。
- 证明 UART 使用 T4（FPGA TX）/N5（FPGA RX），终端参数为 **115200-8-N-1**，终端 Local Echo 关闭。
- 连续记录三个验收点：完整 banner、键盘回显、按 P15 复位后 banner 再次出现；复位重跑至少展示两次。
- 开始录制前关闭无关窗口和通知，终端字体放大到可辨认，保留时间戳或在开头口述日期、板卡和工程名称。

### 6.2 拍前准备

1. 按 §1 建工程并生成 `soc_top.bit`，确认 Hardware Manager 已识别目标器件 `xc7a100tcsg324-1`。
2. 接好 USB-JTAG 与 USB-UART 两根线，确认开发板供电灯 D18、配置灯 D24 状态正常；不要把 `PROG`（P9/PROGRAM_B）当作复位键。
3. 打开串口终端，选择实际 COM 号，设置 115200 baud、8 data bits、No parity、1 stop bit、无流控，并关闭 Local Echo。
4. 先短按 P15 验证低有效复位；等待 banner 完整显示后再开始输入，避免首字符与启动输出重叠。
5. 准备短字符串 `AB` 和连续字符串 `HELLO-RV32I`，便于在镜头中清楚展示逐字回显。

### 6.3 分镜脚本

| 镜头 | 建议时长 | 动作 | 画面必须出现 | 口播要点 |
|---|---:|---|---|---|
| 1 | 10 s | 展示整板、两根 USB 线和复位键位置 | EES-338、JTAG/UART 线、P15 | “这是实验二 UART SoC 实物连接。” |
| 2 | 15 s | 切到 Vivado 工程与 Hardware Manager | 工程顶层 `soc_top`、已生成 bit、目标器件 | “CPU 采用实验一流水线，外设为 UART IP，统一编址 MMIO。” |
| 3 | 10 s | 展示终端串口设置 | 115200-8-N-1、Local Echo 关闭 | “终端按约定参数工作，回显只来自 FPGA。” |
| 4 | 20 s | 松开 P15，等待启动 | 完整 `EES-338 RV32I UART OK` 和 CRLF | “上电或复位释放后，固件先发送启动 banner。” |
| 5 | 20 s | 输入 `AB`，逐字停顿 | 键入字符与终端回显一一对应 | “CPU 轮询 RX_VALID，收到字符后通过 TX 原样发送。” |
| 6 | 20 s | 输入 `HELLO-RV32I` 或快速连续字符 | 连续回显，无乱码、无双写 | “连续收发保持正确，TX_BUSY 时软件等待，不丢字符。” |
| 7 | 15 s | 按住 P15 | 按键动作和输出停止/复位状态 | “按下 P15 触发低有效复位，处理器回到初始状态。” |
| 8 | 20 s | 松开 P15，等待再次启动 | 第二次完整 banner | “释放复位后程序重新运行，banner 再次完整出现。” |
| 9 | 25 s | 再重复一次复位—启动 | 第三次 banner 或终端日志中的两次记录 | “重复复位结果一致，验证复位同步与固件重启。” |
| 10 | 10 s | 收尾定格 | 开发板、终端日志、文件名/日期 | “实验二三项验收均通过，视频与日志按方案归档。” |

> **用仓库内脚本当终端时（无需安装 Tera Term）**：镜头 3 改为展示 `soc/scripts/serial_console.ps1`
> 的启动行 `[OK] COM8 @ 115200 8-N-1 opened`，并展示脚本里"只把串口读回的字节打印到屏幕"
> 那两段代码（它天生不回显键盘）——口播可改成"屏幕上出现的每个字符都只能来自 FPGA"。
> 该脚本的用法见本文 **§10 附录**；录制时**不要**加 `-LocalEcho`（那是排错开关）。

### 6.4 三项验收必须拍到的细节

1. **Banner**：文本须完整可读，不能被窗口滚动或鼠标遮挡；至少出现两次。
2. **回显**：建议先慢速输入 `AB`，再输入较长字符串；每个字符只出现一次，不能用剪辑拼接代替连续收发。
3. **复位重跑**：镜头中明确拍到手指按下、松开 P15 的动作及其前后终端变化；两次复位之间不要重新烧录 bit。

### 6.5 异常情况处理

| 现象 | 处理 |
|---|---|
| 无输出 | 检查 COM、USB-UART 线、bit 是否正确；重新松开 P15 并等待 2 s。 |
| 乱码 | 核对 115200-8-N-1、无流控，并确认没有把 JTAG 口当 UART 口。 |
| 字符双写 | 关闭 Local Echo 后重新录制；双写镜头不作为有效证据。 |
| 首字符丢失 | 等完整 banner 出现后再输入；必要时重新复位，不剪掉启动过程。 |
| 按键无效或卡死 | 确认按的是 P15（低有效），不要按 P9/PROG；检查复位同步与电源。 |
| Banner 不完整 | 停止录制，重新烧录并复位；保留失败日志但提交最终完整视频。 |

### 6.6 视频文件与证据归档

建议将以下文件放入 `soc/doc/board_evidence/`；若仓库策略忽略大视频，可将 MP4 存课程网盘，并在 README 登记链接。

```text
soc/doc/board_evidence/
├─ uart_soc_demo_YYYYMMDD.mp4
├─ uart_soc_terminal_YYYYMMDD.log
├─ uart_soc_board_record_YYYYMMDD.md
└─ README.md
```

记录文件至少包含：拍摄日期、板卡器件、Vivado 版本、bit 文件名与 SHA256、COM 号、串口参数、banner/回显/复位三项结果、视频文件名或外链。

## 7. 常见问题速查（新增异地项，其余见 ../../UART/doc/tasks.md §3.1）

| 现象 | 处理 |
|---|---|
| `get_hw_devices` 为空 / Hardware Manager 找不到板 | USB-JTAG 线未接或驱动未装（本机 USB-UART 为 FTDI VCP；CP2102 板型则是 CP210x）；换口重插；检查 D18 电源灯 |
| 终端无输出 | COM 号错 / 波特率错 / 未复位极性错误（§3 fallback） |
| 输出乱码 | 波特率不一致（必须 115200）或 USB-UART 与 JTAG 两线插反 |
| 发几个字符后停 | 终端开启了本地回显造成"双写"观感≠故障；确认 CPU 回显为唯一来源（关终端本地回显再验） |
| 首字符丢 | 上电瞬间 PC 复位释放即发 banner，属正常时序；重跑验证一致性即可 |
| **按 RESET 后 banner 前面出现乱码/多余字符** | **按键松开抖动**（0.1–5 ms）落在"设计刚开始发 banner"的窗口内，使 core 被反复置位/释放、UART 帧被截断且位节拍错位。**2026-09-16 起已默认开启 20 ms 释放去抖**（`soc_top` 参数 `RESET_STABLE_CYCLES`，见 §9 v1.5）——若仍出现，说明烧的是**去抖前的 bit**，重建后重烧即可；判据是"每次复位后 banner 都逐字节干净"（仿真用例 `tb_soc_console` P5） |
| 本机（原开发机）Vivado 2019.2 综合后器件加载空转 | 已知限制：换本方案任一步骤到健康主机执行即可（工程已全打包） |

## 8. 回传物与收尾

1. `soc_top.bit` 拷回开发机（本机 JTAG 与 COM8 可用时也可继续编程/验收）；
2. 证据文件（终端日志/记录/波形/视频）归入仓库外存档或 `soc/doc/board_evidence/`；
3. 在 `../../UART/doc/tasks.md` U32 状态栏更新：bit 产出（机器/日期）、终端验收三项、视频链接；
4. 若极性或引脚实测与约定不符 → 先改契约文档（`soc/xdc/board.xdc` 头注 / `../../UART/doc/interface.md`）再改实现，禁止单侧改。

## 9. 变更记录

- v1.6 2026-09-16（PR #13 review 加固）：`reset_sync` **释放路径全部移入同步域**——异步级只剩 1 个 `meta_q`，去抖计数与释放链改为纯同步（不再把异步释放沿直接接进计数器复位脚，消除 recovery/removal 亚稳可能"提前满足 stable_ok"、吃掉去抖时长的风险）；**释放时序逐拍不变**（`STABLE_CYCLES=0` 仍 2 拍释放、去抖仍 8+1 拍），`tb_reset_sync` 原断言不改仍 PASS。同时：四个仿真 runner（`run_mut`/`run_mut_alu`/`run_trace_bd`/`run_soc_tb`）改为**并发排空 stdout/stderr**（防管道写满死锁）+ **传播 xvlog/xelab/xsim 非零退出**（"没跑成"不再看起来像"全检出"）；`serial_console.ps1` 的 Enter **不再本地画换行**（换行改由 FPGA 回显的 CR 触发，显示层做 CR→CRLF 归一，新增 `-RawDisplay` 严格模式）；§0/§5/§7 的 USB-UART 桥描述统一为"本机实测 FTDI（手册标 CP2102）"；§10.2 记录 `run_soc_tb.ps1` 实测结果。
- v1.5 2026-09-16：**复位释放去抖**——`rtl/reset_sync.v` 新增 `STABLE_CYCLES` 参数（默认 0=不去抖，行为同旧版），`soc_top` 经 `RESET_STABLE_CYCLES`（默认 **20 ms @100 MHz**）开启；按下仍立即生效。修复现象："按 RESET 后 banner 前面出现乱码/多余字符"（根因＝按键松开抖动使 core 在抖动窗口内反复置位/释放，正在发的 UART 帧被截断 + 位节拍错位）。验证：`tb_reset_sync` 新增去抖单测（抖动被滤除）、`tb_soc_console` 新增 **P5**（抖动式松开 → banner 逐字节干净、无多余字节）。**注意：本改动会改变 bit**——2026-09-16 之前烧录的 bit 不含去抖，需按 §1 重建后重新烧录。
- v1.4 2026-09-15：§1 改为**一条命令建工程**——新增 `soc/scripts/create_soc_proj.tcl`（由 `UART/src/scripts/create_vivado_proj.tcl` 迁移而来；落点统一 `soc/vivado/soc.xpr`，固件副本改放工程内 `soc/vivado/soc_build/imem_init.vh`）；**修正 §1 器件型号**为实测 `xc7a100tcsg324-1`（原写 `xc7a35tcsg324-1`，与实物不符会导致 bit 烧不进板）。
- v1.2 2026-09-07：固件构建脚本保留口径（`UART/src/scripts/build_fw.ps1`）；§1.4 补脚本调用与 .vh 补零（`-PadBytes 512`）→ `imem_init.vh` 复制步骤。
- v1.3 2026-09-15：新增 §6 实验二 SoC 演示视频拍摄方案（拍前准备、10 镜头脚本、三项验收细节、异常处理与证据归档），并明确与实验一视频分开提交。
- v1.1 2026-09-07：随 SoC 上移 `soc/`（本文件随迁）：全部路径改 `soc/` 与 `../exp2/`；构建/烧录/取证脚本已删——§1 改无脚本手动工程步骤、§2 批处理改 Tcl Console 逐条、§4.4 取证改手动等价。
- v1.0 2026-09-06：初版（异地设备完整执行方案）。

---

## 10. 附录：仓库内辅助脚本（演示 / 验证）

| 脚本 | 用途 | 用法 |
|---|---|---|
| `soc/scripts/create_soc_proj.tcl` | 一条命令建 Vivado 工程（口径见 §1） | `vivado -mode batch -source soc/scripts/create_soc_proj.tcl` |
| **`soc/scripts/serial_console.ps1`** | **视频演示 / 终端验收用的最小串口控制台**（免装 Tera Term） | `powershell -File soc/scripts/serial_console.ps1 [-Port COM8] [-Baud 115200] [-Log <路径>] [-LocalEcho] [-RawDisplay]` |
| `soc/scripts/run_soc_tb.ps1` | 跑 SoC/UART 侧 TB（这些**不在** `run_tb.ps1` 的 23 项里） | `powershell -File soc/scripts/run_soc_tb.ps1 [-All]` |

### 10.1 `serial_console.ps1` 操作卡（拍摄用）

1. 打开 PowerShell 窗口，**进入仓库根**后运行（建议显式指定日志名，省去事后改名）：

   ```powershell
   powershell -File soc/scripts/serial_console.ps1 -Log build\uart_soc_terminal_<日期>.log
   ```

2. 看到 `[OK] COM8 @ 115200 8-N-1 opened.  Log: ...` 即已连上——**这一行就是镜头 3 的"串口设置"证据**。
3. 调字号：窗口标题栏右键 → 属性 → 字体（`Consolas` 20）；布局里窗口设 `100×30`、缓冲区高度 `999`（避免滚动条）。
4. 键入即发送（Enter 只发 CR、Backspace 发 BS，**都不本地画字符**）。**敲完屏幕上"先什么都不出现"是正常的**——字符要等 FPGA
   回传才显示，这正是"回显只来自 FPGA"的证据（镜头 5 的观感就在这一前一后）。回车后的换行来自 **FPGA 回显的那个 CR**：
   显示层把裸 CR 归一成 CRLF（等价 PuTTY/Tera Term 的 "Implicit LF in every CR"），日志里仍是原始字节。
5. 退出：`Ctrl+C` → 打印 `[OK] closed. Log saved: ...`；日志已 `AutoFlush`，直接关窗口也不会丢。

| 开关 | 说明 |
|---|---|
| `-Port COM8` / `-Baud 115200` | 端口 / 波特率（默认 COM8、115200、8N1、无流控） |
| `-Log <路径>` | 日志路径；默认 `<repo>/build/uart_log_<时间戳>.txt`（`build/` 不入库）；**日志始终是 FPGA 原始字节** |
| `-LocalEcho` | **排错用**：把真正发出的键显示成 `[TX:a]`。看到它 = 按键已进脚本；看不到 = 按键没进窗口（输入法/焦点/窗口选错）。**录制时必须保持关闭** |
| `-RawDisplay` | 严格逐字节显示（不做 CR→CRLF 归一）。屏幕上每个字节都等于 FPGA 发出的字节，适合当"逐字节一致"的证据截图 |

> 日志文件就是 §5/§6.6 要的"终端日志"证据；收尾时按规范改名归档（如 `uart_soc_terminal_YYYYMMDD.log`）。

### 10.2 `run_soc_tb.ps1`（SoC 侧回归）

```powershell
powershell -File soc/scripts/run_soc_tb.ps1          # 默认 3 项：tb_reset_sync / tb_soc_console / tb_soc_full
powershell -File soc/scripts/run_soc_tb.ps1 -All     # soc/test + UART/src/test 的全部 tb_*.v
```

产物在 `build/soc_sim_out/<tb>/`（`xvlog/xelab/xsim` 日志，判据是 `sim.log` 里出现 `ALL PASS`）。
2026-09-16 **复位释放去抖**改动后的实测结果：**3/3 PASS**（含 `tb_soc_console` 新增的 P5 抖动用例）。
