StarryReverie/board/UART/doc/future_extensions.md

# 未来可拓展功能设想（汇编实验侧）

> 定位：登记讨论中出现但**本期不实现**的扩展，避免遗忘与重复讨论。凡决定实现，须先回写 `top_design.md`/`tasks.md`/`interface.md` 正文（及计组侧契约），本文件不冻结任何契约。
>
> 现状基线：全双工 UART（8N1@115200、TX/STAT/RX 槽、轮询无 FIFO/无中断）、统一编址 MMIO（0x4000 窗口）、程序固化单程序模型（无 loader）、EES-338 下板。

## 1. 收发 FIFO / 中断（性能与体验增强）

- **设想**：uart_ip_top 寄存器层内加 RX FIFO（如 16 深）消除轮询丢字节窗口；TX 侧 FIFO 支持整串写入；可选"RX 非空中断"（需计组侧加中断机制，成本高）。
- **改动/成本**：中/高——RX FIFO 仅动 uart_ip_top 寄存器层（小）；中断涉及 CPU 架构（计组 future_extensions §6 已否决本轮）。
- **触发条件**：吞吐成为瓶颈、演示需大数据量接收；9/18 前不建议。

## 2. ILA 应用（任务书可选加分项）

- **设想**：Vivado ILA 探针挂 uart 总线/uart_tx/uart_rx 波形，答辩展示内部时序。
- **改动/成本**：小（核生成 + 触发设置），但挤占时间。
- **触发条件**：主线（U10–U32）提前闭环且时间有余量（tasks.md U33）。

## 3. MMIO 窗口扩展更多从机（LED/按键/数码管/蓝牙/以太网）

- **设想**：dbus_decode 窗口按 `reg_off` 或扩窗口宽度接第二从机；板上已有蓝牙（BLE-CC41-A，9600 默认）、以太网 CH395Q、LED/按键等资源（见 `../../pipeline/doc/future_extensions.md` §4）。
- **改动/成本**：小/中——dbus_decode 从机选择与 rdata mux 扩展、新从机 IP。
- **触发条件**：接口课后续练习或答辩需要多外设演示。

## 4. 波特率可配寄存器 / 自动波特率

- **设想**：把 clk_en 分频除数做成 MMIO 可写（波特率寄存器），固件可切 9600/115200…。
- **改动/成本**：小（加 1 个槽 + 除数重载逻辑），需保证切换时序（发完当前字节再切）。
- **触发条件**：演示"与不同速率设备通信"。

## 5. 恢复"运行期换程序"（与计组 loader 的关系）

- 计组侧 loader/在线重载已搁置（程序固化模型）；本实验固件固定。若未来恢复：loader 需经 UART RX 收字节流，uart_rx 的归属（uart_ip_top 寄存器层 vs loader）与装载窗口需重新协商——见计组 `future_extensions.md` §1/§2 与 tasks §6 说明。
- **触发条件**：换程序不重烧成为硬需求（本期否）。

## 6. 变更记录

- v1.0 2026-09-04：初版。
