StarryReverie/board/pipeline/doc/perf_report.md

# 实验一性能分析报告（完成版 v2.2）

> 测量日期：2026-09-14（结构层首次）／**2026-09-17 复测**（实现策略优化后）｜ DUT：`pipeline_top`（`SOC_BUILD=0`）｜ 仿真器：Vivado 2019.2 xsim
> 器件与时序：`xc7a100tcsg324-1`，100 MHz 名义时钟（`Tclk=10 ns`）
> 原始数据：`pipeline/doc/perf_data/2026-09-14_perf_summary.csv`、**`pipeline/doc/perf_data/2026-09-17_perf_summary.csv`（逐行一致）**
> 时序资源层：§4 的综合口径（post-synthesis、4 KB）+ **2026-09-17 下板构建口径（post-route、512 B/256 B）**，见 `pipeline/doc/perf_data/2026-09-17_buildD_postroute.md`
> **口径提示**：本轮的"优化"是**实现策略优化**（`Performance_Explore` + 前置/布线后 `phys_opt AggressiveExplore`），**未改动 RTL**，因此结构层（CPI/IPC/MIPS/CPU time）数字与 2026-09-14 完全一致；变化只发生在时序资源层。
> **注意区分两件事**：①"策略优化未改 RTL"指本轮优化本身；②下板构建 D 与历史构建 C 之间**存在 RTL 版本差异**（C 为去抖前、D 含复位释放去抖），故二者的 WNS 差属跨版本观测值，归因限定见 §4.1。

## 1. 评价指标与测量口径

### 1.1 指标选择与依据

| 指标 | 含义 | 优点 | 局限 | 本报告用途 |
|---|---|---|---|---|
| **CPI** | 每条指令占用的平均周期数，`C/IC` | 与频率、工艺解耦，直接暴露流水线停顿 | 单一数值不能显示停顿构成 | **主指标** |
| **IPC** | 每周期完成的平均指令数，`1/CPI` | 便于表达吞吐并与单周期对照 | 与 CPI 信息重复 | 对照列 |
| **MIPS** | 每秒百万条指令 | 直观，便于表示实际吞吐 | 依赖时钟频率，跨设计比较会混入频率因素 | 频率维度 |
| **CPU time** | 完成程序所需时间，`C×Tclk` | 最贴近端到端运行速度 | 同样依赖频率 | 频率维度 |

选择依据如下：流水线的目标是在保持吞吐的同时缩短关键路径，因此首先用与频率无关的 CPI 衡量结构效率；单周期 CPU 每条指令一拍完成，`CPI=1`，可作为天然结构基准；MIPS 与 CPU time 则用于回答“提高最高频率能否覆盖流水线停顿损失”。因此本报告以 **CPI 为主指标、IPC 为对照、MIPS 和 CPU time 为频率维度指标**。

### 1.2 时间窗口与符号

为避免把流水线特有的停机尾部开销算入结构对比，测量同时保留三个窗口：

| 窗口 | 定义 | 用途 |
|---|---|---|
| `C_total` | 复位释放至停机自旋首个真实 EX 槽，再加停机尾 `D` 拍 | 端到端完成时间 |
| **`C_steady`** | `C_total - C_fixed = IC + L + 2T - 3` | **主对比口径** |
| `C_fixed` | `1 + D = 3`，即停机自旋 1 拍加冲刷尾 2 拍 | 解释短程序 CPI 偏高 |

单周期基线的 `IC` 不包含复位填充和停机冲刷尾。使用 `C_total` 直接对比会把流水线自己的固定开销重复计入，因此结构对比采用 `C_steady`。

| 符号 | 测量判据 |
|---|---|
| `IC` | EX 槽控制字非全零的真实指令槽数，包含末尾停机自旋指令；气泡/复位槽控制字全零 |
| `IC_useful` | `IC-1`，剔除末尾停机自旋后的有效指令数 |
| `F` | 首个真实 EX 槽的沿号，本轮各档实测为 1 |
| `L` | `stall` 拉高的沿数，即 load-use 冻结拍数 |
| `T` | `br_taken` 有效次数，包含 taken 分支、`jal` 和 `jalr` |
| `h` | 停机自旋首个真实 EX 槽沿号，以真实槽且 `idex_pc==br_target` 连续 2 拍判定 |
| `D` | 停机尾拍数，本轮实测为 2 |

### 1.3 公式与恒等式自检

| 指标/校验 | 公式 |
|---|---|
| `CPI_total` | `C_total / IC` |
| **`CPI_steady`** | `C_steady / IC_useful` |
| `IPC_steady` | `IC_useful / C_steady` |
| `MIPS` | `IC_useful / (C_total × Tclk) × 10^-6` |
| `CPU time` | `C_total × Tclk` |
| 结构加速比 | `S_struct = IC_useful / C_steady`，单周期 `CPI=1` |
| 频率加速比 | `S_freq = Fmax_pipe / Fmax_single` |
| 时间加速比 | `S_time = S_struct × S_freq` |

每档必须满足：

```text
C_total  = IC + (F - 1) + L + 2T
C_steady = IC + L + 2T - C_fixed
residual = C_steady - (IC + L + 2T - C_fixed) = 0
```

## 2. 工作负载与流水线仿真结果

### 2.1 工作负载说明

| 程序 | 静态字数 | 实测 IC | 特征 | 用途 |
|---|---:|---:|---|---|
| `test0` | 10 | 10 | 无循环、无 load-use | 最小基线 |
| `test1` | 21 | 19 | 混合运算与存取 | 常规负载 |
| `sort` | 36 | 177 | 冒泡排序双循环、分支密集 | **主对比负载** |
| `cover`（`instr_cover`） | — | 33 | 覆盖 26 条冻结指令 | 指令构成样本 |
| `hazard`（`hazard_cover`） | — | 16 | 人造依赖链 | 停顿放大镜 |
| `loop8`（`loop_heavy_8`） | 17 | 87 | 循环与数组读写，`N=8` | 规模档下界 |
| `loop32`（`loop_heavy_32`） | 17 | 327 | 同上，`N=32` | 规模档中档 |
| `loop128`（`loop_heavy_128`） | 17 | 1287 | 同上，`N=128` | 规模档上界 |

`test0`、`test1` 和 `sort` 与单周期参考工程使用同源镜像，可直接对比。`cover`、`hazard` 和三个 `loop_heavy` 规模档只用于流水线侧分析：其中包含单周期译码器不支持的指令，或用于放大流水线停顿，不能作为单周期对比负载。

### 2.2 仿真统计

| 程序 | IC | IC_useful | C_total | C_steady | L | T | CPI_total | CPI_steady | IPC_steady | MIPS@100M | time(ns) |
|---|---:|---:|---:|---:|---:|---:|---:|---:|---:|---:|---:|
| test0 | 10 | 9 | 12 | 9 | 0 | 1 | 1.200 | 1.000 | 1.000 | 75.000 | 120 |
| test1 | 19 | 18 | 24 | 21 | 1 | 2 | 1.263 | 1.167 | 0.857 | 75.000 | 240 |
| sort | 177 | 176 | 247 | 244 | 10 | 30 | 1.395 | 1.386 | 0.721 | 71.255 | 2470 |
| cover | 33 | 32 | 43 | 40 | 0 | 5 | 1.303 | 1.250 | 0.800 | 74.419 | 430 |
| hazard | 16 | 15 | 22 | 19 | 2 | 2 | 1.375 | 1.267 | 0.789 | 68.182 | 220 |
| loop8 | 87 | 86 | 119 | 116 | 16 | 8 | 1.368 | 1.349 | 0.741 | 72.269 | 1190 |
| loop32 | 327 | 326 | 455 | 452 | 64 | 32 | 1.391 | 1.387 | 0.721 | 71.648 | 4550 |
| loop128 | 1287 | 1286 | 1799 | 1796 | 256 | 128 | 1.398 | 1.397 | 0.716 | 71.484 | 17990 |

所有档位的恒等式 A/B 均通过，`residual=0`。`F=1`，因此表中数据满足 `C_total=IC+L+2T`。

### 2.3 停顿构成与规模趋势

在稳态窗口中，停顿可按 `IC_useful + L + 2(T-1) = C_steady` 分解，其中 `T-1` 排除了末尾停机自旋的重定向：

- load-use 冻结占 `C_steady` 的 0%（`test0`、`cover`）到 10.5%（`hazard`）；`sort` 为 4.1%。
- 非停机分支/跳转冲刷占 0%（`test0`）到 23.8%（`sort`），是长程序的主要额外开销。
- 固定开销 `C_fixed/C_total` 从 `test0` 的 25.0% 降至 `loop128` 的 0.17%，说明短程序 CPI 偏高主要来自停机固定开销。
- `loop8/32/128` 中 `L=2N`、`T=N`，`CPI_steady` 从 1.349 收敛至 1.397，反映循环体自身的停顿结构。

三个规模档包含重复的 load-use 与回边分支，用于观察停顿随规模的收敛。当前性能 TB 只断言控制流收敛，不把 `x8` 终值作为功能正确性证据；这是一项测试范围限定，并非已确认的 RTL 缺陷。此前的 L1 线索因见证程序期望值错误已撤销，审计记录见 `pipeline/doc/known_issues.md`。

## 3. 与大三单周期 CPU 的对比

### 3.1 单周期 CPU 结构与工作原理

单周期参考工程顶层为 `ref/CPU/cpu_top.v`，对外只有 `clk` 和 `rst`。主要组成如下：

| 模块 | 作用 |
|---|---|
| `pc_reg` | 产生 `pc+4` 或分支目标 `pc_branch` |
| `rom` | 4 KB 指令存储，组合读 |
| `instr_decoder` | 拆分指令字段并生成五型立即数 |
| `regfile` | `x[31:1]`，`x0` 恒为 0，异步读、时钟沿写 |
| `control` | 硬布线主译码 |
| `alu` | 33 位结果与 `ZF/SF/CF/OF/PF` 标志 |
| `ram` | 4 KB 数据存储，组合读、按字节掩码写 |

一条指令在一个时钟周期内完成“取指 → 译码 → 读寄存器 → ALU → 访存 → 写回”，所以 `CPI=1`，但取指到写回的整条通路都位于同一关键路径中。它没有段间寄存器，也不需要流水线数据冒险处理；分支由顶层集中判决，组合读存储器则限制了大容量 BRAM 映射和最高频率。

### 3.2 基线来源与可比性

基线优先采用组内成员大三阶段单周期 CPU 的实验数据。当前仓库没有找到原始大三报告数字，因此对只读副本 `ref/CPU/` 做了同器件、同工具、同约束复测，并明确标注为“本轮实测”：

| 检查项 | 本轮结论 |
|---|---|
| 器件 | `xc7a100tcsg324-1` |
| 工具 | Vivado 2019.2 |
| 时钟约束 | 100 MHz（10 ns） |
| 同源程序 | 仅 `test0`、`test1`、`sort` |
| 单周期拍数 | `test0/test1/sort = 11/20/178` |
| 单周期 CPI | 按每条指令一拍定义为 1.00，并由仿真交叉验证 |

`ref/CPU` 的 ROM/RAM 在综合时需要初值才能保留数据通路；本轮综合副本只增加 `$readmemh` 初值和 PC 上电值，不增加或删除逻辑，属于测量条件，不改变参考设计。详见 `pipeline/doc/ref_baseline_measured.md`。

### 3.3 结构层对比

| 程序 | 单周期实测拍数 | 单周期 CPI | 流水线 C_steady | 流水线 CPI_steady | 结构加速比 `IC_useful/C_steady` |
|---|---:|---:|---:|---:|---:|
| test0 | 11 | 1.000 | 9 | 1.000 | 1.000 |
| test1 | 20 | 1.000 | 21 | 1.167 | 0.857 |
| sort | 178 | 1.000 | 244 | 1.386 | 0.721 |

结构加速比小于 1 并不矛盾：流水线的 `C_steady` 包含 load-use 冻结和分支冲刷，而单周期没有这些停顿；流水线的潜在收益来自更高的 `Fmax`。

## 4. 资源与时序综合

两种设计均在 Vivado 2019.2、`xc7a100tcsg324-1`、10 ns 时钟约束下，使用两阶段流程综合。存储器保持字节数组实现，均未映射为 BRAM；因此 LUT 绝对值主要反映存储实现方式，不能直接解释为控制逻辑规模。

| 设计 | Slice LUT | FF | BRAM | WNS(ns) | 关键路径(ns) | Fmax估计(MHz) |
|---|---:|---:|---:|---:|---:|---:|
| 单周期（ref/CPU） | 141,854 (223.74%) | 33,768 (26.63%) | 0 | -2.950 | 12.846 | 77.22 |
| 流水线 | 142,009 (223.99%) | 34,159 (26.94%) | 0 | -2.782 | 12.646 | 78.24 |

两者均超过 XC7A100T 的 LUT 容量，表中 Fmax 是 post-synthesis 估计值，不代表当前版本可以直接上板实现。流水线 WNS 改善 0.168 ns，Fmax 仅提升 `78.24/77.22 - 1 = 1.32%`；关键路径仍受组合存储和译码逻辑影响。

频率维度使用 `T=C/f` 推算，不另做多次综合：

| 频率口径 | 用途 | 计算 |
|---|---|---|
| 100 MHz（名义） | 与大三单周期在同频条件下比较 | 按 `C×10 ns` 计算 CPU time 和 MIPS |
| `Fmax_pipe` | 估算流水线实际可达到的最高频率 | 按 `C/Fmax_pipe` 计算 |
| `Fmax_single` | 估算单周期基线实际可达到的最高频率 | 按 `C/Fmax_single` 计算 |

上述口径是基于综合结果的换算，不另做多次综合。若缺少某一设计的 Fmax，应只报告结构层结论，不对缺失数据进行推算。

### 4.1 下板构建口径（2026-09-17，实现策略优化后）

上表是 **post-synthesis、4 KB/1 KB×2** 口径（两者均超器件容量）。另有一份**可上板口径**的实测：**当前 RTL（含复位释放去抖）**、同一固件（123 条 / 492 B）、存储缩容 **IMEM 512 B / DMEM 256 B**、实现策略 `Performance_Explore` + 前置与布线后 `phys_opt AggressiveExplore`：

| 指标 | 值 |
|---|---|
| WNS / TNS | **−1.347 ns** / −273.660 ns（`Timing constraints are not met`） |
| 违例端点（setup） | 268 / 8948（保持 0、脉宽 0） |
| 等价 Fmax | `1000/(10+1.347)` ≈ **88.13 MHz** |
| 资源（post-route） | **12,171 LUT（19.20%）/ 3,864 FF（3.05%）/ 0 BRAM / 34 IOB** |
| 布线前后 | routed WNS −1.646 ns → 布线后物理优化 −1.347 ns（该阶段自身改善 **0.299 ns**） |
| 最差路径 | `u_ex_mem/exmem_mem_read_reg` → `u_id_ex/idex_rs2_reg[0]`，10.978 ns（logic 3.439 / **route 7.539**），18 级（`CARRY4=7`） |

**归因限定（必读）**：与历史构建 C（WNS −1.430 ns）的对比**跨 RTL 版本**——C 为去抖前 RTL，本构建含复位释放去抖，故 `−1.430 → −1.347 ns` 属**观测结果**，**不能单独归因于实现策略**；只体现物理优化增益的是**同一构建内**的 `routed −1.646 → post-route phys_opt −1.347 ns = 0.299 ns`。要单独定量策略效果需要同 RTL 的对照构建（本轮未做）。

**可比性声明（必读）**：该行是 **post-route + 缩容** 口径，**不能与上表单周期的 77.22 MHz（post-synthesis、4 KB）直接相比**——流程阶段与存储容量都不同。因此 **§5 的频率加速比与时间加速比维持综合口径（78.24/77.22 = 1.0132）不变**；若要用下板口径重算时间加速比，需对单周期基线做**同器件/同工具/同约束/同流程/同容量**的实现运行（本轮未做，文档已按"不可直接比较"登记）。

## 5. 系统层结论

频率加速比为 `S_freq = 78.24/77.22 = 1.0132`。将其与结构加速比相乘，得到基于有效指令窗口的时间加速比：

| 程序 | 结构加速比 | 频率加速比 | 时间加速比 `S_struct×S_freq` |
|---|---:|---:|---:|
| test0 | 1.000 | 1.013 | 1.013 |
| test1 | 0.857 | 1.013 | 0.868 |
| sort | 0.721 | 1.013 | 0.731 |

当前综合条件下，频率收益不足以覆盖流水线结构停顿：`test1` 和 `sort` 的有效指令窗口仍慢于 CPI=1 的单周期基线。若按各自 Fmax 计算完整 `C_total`，流水线相对单周期的时间比分别约为 0.929、0.844、0.730；端点停机窗口会改变绝对值，但不改变结论方向。

## 6. 结论与改进方向

1. 流水线稳态 CPI 在同源主负载上为 1.000、1.167、1.386，在规模档收敛到约 1.40；主要额外开销来自 taken 分支/跳转冲刷，其次是 load-use 冻结。
2. 停机固定开销占比随程序规模迅速摊薄：`test0` 为 25.0%，`loop128` 仅 0.17%。
3. 同频下单周期 `CPI=1`，流水线结构加速比为 0.721–1.000；流水线必须依靠显著提频才可能获益。
4. 综合口径下 Fmax 只提高 1.32%（78.24/77.22），不足以抵消 `sort` 等负载的 CPI 损失。**2026-09-17 的实现策略优化**后，下板口径（post-route、缩容 512 B/256 B）实测 WNS **−1.347 ns**（等价 Fmax **88.13 MHz**），但仍**未在 100 MHz 收敛**、且与基线不同口径不能直接换算收益。**归因限定**：与构建 C（−1.430 ns）的差值**跨 RTL 版本**（C 为去抖前 RTL），属观测结果，不能单独归因于实现策略；同一构建内的物理优化增益为 `routed −1.646 → phys_opt −1.347 ns = 0.299 ns`。优化优先级应为：把 imem/dmem 改为可推断 BRAM（同步读，同时缓解资源与关键路径）、减少分支冲刷、改进 load-use 前递。

## 7. 可复现性与证据

- 性能运行器：`pipeline/src/scripts/run_perf.ps1`
- 测量 TB：`pipeline/src/test/tb_perf.v`
- 原始 CSV：`pipeline/doc/perf_data/2026-09-14_perf_summary.csv`、**`pipeline/doc/perf_data/2026-09-17_perf_summary.csv`**
- 单周期基线：`pipeline/doc/ref_baseline_measured.md`
- 下板构建口径证据（构建 D）：`pipeline/doc/perf_data/2026-09-17_buildD_postroute.md`、`pipeline/doc/board_runbook.md` §3.3/§10.5（bit SHA256 `D866924E…0AD93F`）
- 流水线综合：`build/pipe_synth/run/util.rpt`、`build/pipe_synth/run/timing.rpt`
- 单周期综合：`build/ref_synth/run/util.rpt`、`build/ref_synth/run/timing.rpt`

复现命令：

```powershell
powershell -File pipeline/src/scripts/run_perf.ps1
```

**2026-09-17 复测结果（实现策略优化后）**：`run_perf.ps1` 8/8 档通过、恒等式 A/B 全 1、`residual=0`、5 个主档功能门禁通过、3 个规模档按口径排除完整功能证据；生成的 `perf_summary.csv` 与 2026-09-14 版**逐行完全一致**（优化不改 RTL ⇒ 结构层指标不变）。同日重跑 `run_tb.ps1` **23/23 PASS**（24 s）作为功能回归门禁。

> 注意：`run_perf.ps1` 与 `run_tb.ps1` **共用 `pipeline/src/scripts/out/` 输出目录**，两者不可并行执行（后者启动时会清空该目录），必须串行，否则会互相破坏产物。

2026-09-14 复测结果：8/8 性能档通过；每档恒等式 A/B=1，`residual=0`，5 个主档功能门禁通过，3 个规模档控制流检查通过且明确排除完整功能证据。报告中的每个统计数字均可回溯至 CSV 或 `ref_baseline_measured.md` 的对应章节。
