StarryReverie/board/pipeline/doc/perf_analysis.md

# 性能分析方案 — 流水线 vs 大三单周期（实验一 · v2.1）

> **版本**：v2.1（2026-09-14）｜**取代 v1.0**（原 5 档 + 理论基线口径，已删除）
> **课程要求（原文要点）**：量化测试与分析 CPU 性能；可选 CPI / IPC / MIPS / CPU 时间，须阐明**选指标的依据**；须与**大三课程实现的单周期 CPU** 做对比，**以组内成员大三阶段的实验数据为基准**；报告中须对该单周期 CPU 的**基本结构与工作原理**作简要介绍。**本部分为今年报告的重点核查对象**——
> 因此本方案的两条铁律：**① 数据真实（每个数字有出处、可复现）② 依据充分（选指标有理由、对比有口径）**。
> **DUT**：`pipeline_top`（`SOC_BUILD=0`，实验一 CPU core），RTL 零改动，观测全走 TB 层次引用
> **基线**：本轮按同器件、同工具、同约束复测的 `ref/CPU/` 单周期工程；组内成员大三阶段原始记录当前未提供，后续取得后再交叉核对
> **器件/工具**：`xc7a100tcsg324-1`、Vivado 2019.2；**时钟**：100 MHz 名义（Tclk = 10 ns）
> **配套产物**：实测结果 `pipeline/doc/perf_report.md`（v2 完成版）；测量 TB `pipeline/src/test/tb_perf.v`；运行器 `pipeline/src/scripts/run_perf.ps1`

---

## 1. 评价指标的选择与依据（要求点①）

### 1.1 候选指标与取舍

| 指标 | 含义 | 优点 | 局限 | 本实验采用 |
|---|---|---|---|---|
| **CPI** | 每指令拍数 = C/IC | 与时钟、工艺无关，**直接暴露流水线设计效率**（停顿就是 CPI 超 1 的部分） | 单一数字掩盖停顿构成 | **主指标** |
| **IPC** | 每拍指令数 = 1/CPI | 与"结构加速比"同值，便于与大三单周期直接对照 | 与 CPI 冗余 | **采用（作对照列）** |
| **MIPS** | 每秒百万条指令 | 直观、可与教科书对照 | **依赖时钟频率**，跨设计比会混入频率因素 | **采用（频率维度）** |
| **CPU 时间** | C × Tclk | 端到端完成时间，最贴近"跑得快不快" | 同上依赖频率 | **采用（频率维度）** |

### 1.2 依据（写进报告的三句话）

1. **流水线设计的目标是"在不牺牲吞吐的前提下缩短关键路径"**，因此最能反映设计质量的是**与频率无关的 CPI**——它把"设计效率"和"工艺/频率"两个因素分开；
2. 单周期 CPU 的 **CPI ≡ 1**（每条指令一拍完成，无填充、无停顿），是所有对比的天然基准线；因此 **CPI 之比 = 结构加速比**，可直接量化"流水线为换取频率付出了多少吞吐代价"；
3. **MIPS 与 CPU 时间必须报，但只在"频率维度"报**——因为流水线的收益来自可达到的最高频率，这两个指标用来回答"提频收益能否覆盖 CPI>1 的损失"。

> 报告口径句："我们以 **CPI 为主指标、IPC 为对照、MIPS 与 CPU 时间用于频率维度**；选择依据是 CPI 与频率解耦，能单独衡量流水线设计效率。"

---

## 2. 测量口径（口径唯一、可复现）

### 2.1 时间窗口（三口径）

| 窗口 | 定义 | 用途 |
|---|---|---|
| `C_total` | 复位释放 → 停机自旋首个真实 EX 槽 **+ D 拍**（停机尾，实测） | 端到端完成时间 |
| **`C_steady`** | `C_total − C_fixed = IC + L + 2T − 3` | **主口径**（剔除停机指令与冲刷尾） |
| `C_fixed` | `1 + D = 3`（停机自旋 1 拍 + 冲刷尾 `D=2`） | 解释"短程序 CPI 偏高" |

> **为什么对比用 `C_steady`**：单周期基线 `IC` 不含"复位填充 + 停机冲刷尾"这类**流水线特有开销**；若用 `C_total` 对比，等于把自己的固定开销算进去、低估流水线。

### 2.2 符号与判据（全部可测量）

| 符号 | 判据 |
|---|---|
| `IC` | **EX 槽控制字非全零**的真实指令槽数，包含末尾停机自旋指令（气泡/复位槽控制字全零；不用 `inst≠0/0x13` 判据） |
| `IC_useful` | `IC − 1`，剔除末尾停机自旋后的有效程序指令数 |
| `F` | 首个真实 EX 槽的沿号（实测，期望 1） |
| `L` | `stall` 拉高沿数（load-use 冻结） |
| `T` | `br_taken` 有效次数（分支 taken + `jal/jalr`） |
| `h` | 停机自旋首个真实 EX 槽沿号（真实槽 + `idex_pc==br_target` **连续 2 拍**成立） |
| `D` | 停机尾拍数（实测，v1.0 实测为 2） |

### 2.3 指标公式与自检

| 指标 | 公式 |
|---|---|
| `CPI_total` | `C_total / IC` |
| **`CPI_steady`** | `C_steady / IC_useful` |
| `IPC_steady` | `IC_useful / C_steady` |
| `MIPS` | `IC_useful / (C_total × Tclk) × 10⁻⁶`（有效指令吞吐） |
| `CPU time` | `C_total × Tclk` |
| **结构加速比** | `IC_useful / C_steady`（单周期 CPI=1 的有效指令基准） |
| **时间加速比** | `(IC_useful / C_steady) × (Fmax_pipe / Fmax_单周期)` |

**自检恒等式（必须全 PASS，否则数据无效）**：

```
恒等式 A：C_total == IC + (F−1) + L + 2T
恒等式 B：C_steady == IC + L + 2T − C_fixed
收尾项：  D == C_total − h          （与实测一致）
```

---

## 3. 工作负载（4 主档 + 1 覆盖档 + 3 规模档）

| # | 程序 | 静态字数 | 实测 IC | 特征 | 用于 |
|---|---|---|---|---|---|
| 1 | `test0` | 10 | 10 | 无循环、无 load-use | 最小基线 + 固定开销参考 |
| 2 | `test1` | 21 | 19 | 混合运算/存取 | 常规负载 |
| 3 | `sort` | 36 | 177 | 冒泡排序双循环、分支密集 | **主对比负载** |
| 4 | `instr_cover` | — | 33 | 26 条冻结指令全覆盖 | 覆盖正确性 + 指令构成样本 |
| 5 | `hazard_cover` | — | 16 | 人造依赖链 | 停顿"放大镜" |
| 6 | `loop_heavy_8` | 17 | 87 | 循环 + 数组读写，N=8 | 规模档下界 |
| 7 | `loop_heavy_32` | 17 | 327 | 同上，N=32 | 规模档中档 |
| 8 | `loop_heavy_128` | 17 | 1287 | 同上，N=128 | 规模档上界（CPI 收敛证据） |

- 第 1–3 档**与大三单周期同源**（同一 `.asm` → 同一镜像，逐字节核对后使用），可直接对比；
- 第 4–5 档用于**指令构成与停顿构成**分析；
- 第 6–8 档**只用于流水线侧**（回答"短程序 CPI 偏高是固定开销所致"），不参与单周期对比。
  三档为**同一程序的三个循环次数**（生成期替换常数），故除规模外无算法差异，收敛趋势可直接比较。
- **第 6–8 档的使用限制**：规模档专门用于放大循环负载和观察 CPI 收敛，当前性能 TB 只断言控制流收敛
  （`x5` 归零、`dmem[0]`/`dmem[4]` 递增 N 次），不把 `x8` 作为功能正确性证据；此前关于“累加寄存器自 RAW × load-use”的 L1 线索已因见证程序期望值错误而撤销，详见 `pipeline/doc/known_issues.md`。

> 删减说明：原 v2 草案的 6 主档 + 3 规模档最终落实为"5 档（含覆盖档）+ 3 规模档"共 8 档；
> 规模档由"N 放大 `sort`"改为**新写 `loop_heavy`**（可控、不受排序算法扰动）。

---

## 4. 与大三单周期 CPU 的对比（要求点②③，重点核查）

### 4.1 单周期 CPU 基本结构与工作原理（报告须简述，素材已就绪）

> 素材来源：`pipeline/doc/ref_note.md` §1–§3（已完成梳理）+ `ref/CPU/` 源码。

| 项 | 内容（报告约 1 页 + 1 张数据通路图） |
|---|---|
| 顶层 | `cpu_top.v`，对外**仅 `clk`/`rst`** |
| 组成 | `pc_reg`（PC：`pc_pred=pc+4`，`pc_next=pc_src?pc_branch:pc_pred`）、`rom`（指令存储 4 KB，**组合读**）、`instr_decoder`（拆字段 + 五型立即数）、`regfile`（`x[31:1]`，`x0≡0`，异步读/边缘写）、`control`（硬布线主译码）、`alu`（33 位结果 + `flags{ZF,SF,CF,OF,PF}`）、`ram`（数据存储 4 KB，`wmask` 字节写） |
| 工作原理 | **一条指令在一个时钟周期内走完全部数据通路**：取指 → 译码 → 读寄存器 → ALU 运算 → 访存 → 写回；因此 **CPI ≡ 1**，但**关键路径 = 整条通路串联**（取指到写回），限制了最高频率 |
| 与流水线的差异 | ① 无段间寄存器；② **无数据冒险处理需求**（一拍完成读写）；③ 分支在顶层集中判决（`pc_src` + `flags[ZF]`）；④ 存储为组合读（大数组组合读难以映射为 BRAM） |

> 报告口径句："单周期 CPU 以面积与关键路径为代价换取 CPI≡1；本设计以 CPI>1 与流水线寄存器为代价换取更短的关键路径，性能对比的本质是这两者的权衡。"

### 4.2 基线数据来源与可比性（要求②）

| 项 | 做法 |
|---|---|
| 数据来源 | 首选组内成员**大三课程设计的报告/实测记录**；当前原始记录缺失，采用 `ref/CPU/` 只读副本的同条件复测作为一级来源 |
| 引用要求 | 报告中**逐项注明出处**（"大三课程设计报告 §x 表 y"）与**测试条件**（器件、工具版本、时钟约束、程序） |
| **可比性检查（必做）** | 逐条核对：① 是否同器件 `xc7a100tcsg324-1`；② 是否同工具（Vivado 2019.2）；③ 时钟约束是否为 100 MHz；④ 程序是否为同源镜像（`test0`/`test1`/`sort`）。**条件不同的项必须在报告里显式说明并标注"不可直接比较"** |
| 数据缺失时 | 若大三数据未记录某项（如 Fmax 或资源），则该项**留空并标注"大三未记录"**；当前复测数据必须标注"本轮实测"，**绝不推算、绝不编数** |

### 4.2.1 本轮已完成的补充实测（**优先采用**）

由于"大三阶段数据"目前**没有现成记录**，本轮已对仓库内的只读副本 `ref/CPU/`（即该单周期 CPU 本体）
做了**同口径实测**，作为基线的**一级来源**；若后续找到当年报告中的原始记录，应与之交叉核对：

| 项 | 状态 | 出处 |
|---|---|---|
| 拍数（test0/test1/sort） | ✅ **已实测**：11 / 20 / 178 拍，且 `C_total = IC_流水线 + 1` 精确成立 | `pipeline/doc/ref_baseline_measured.md` §2 |
| 单周期 `CPI` | ✅ **已确认 ≡ 1.00**（每拍 1 条指令，实测交叉验证） | 同上 |
| 资源（LUT/FF/BRAM）与 Fmax | ✅ 已完成：单周期与流水线均按同器件/同约束综合 | `pipeline/doc/ref_baseline_measured.md` §3、流水线综合报告 |
| 同源可比范围 | ✅ **只有 test0/test1/sort**：`control.v` 主译码仅支持 `R型(ADD/SUB)/ORI/LW/SW/BEQ/JAL`，`instr_cover`/`hazard_cover`/`loop_heavy` 含其不支持的指令（`bne`/移位/比较/`lui` 等），**不参与单周期对比** | `pipeline/doc/ref_baseline_measured.md` §1.1 |

> **口径声明（写入报告时必须保留）**：`ref/CPU` 的存储无 RTL 初值（仿真期由 TB `$readmemh` 装载），
> 直接综合会得到空设计（实测 0 LUT / 无时序路径）。综合副本仅加 `rom.v` 的 `$readmemh` 初值与
> `pc_reg.v` 的上电初值——**不新增/删除任何逻辑**，属测量条件而非设计改动；资源/关键路径与仿真设计一致。
> 详见 `pipeline/doc/ref_baseline_measured.md` §3.1。

### 4.2.2 与"不做的事"的边界

| 项 | 说明 |
|---|---|
| **不做的事** | 不臆造大三报告数字；不把 `IC` 当拍数（本设计已实测拍数，无需"按定义折算"）；不修改 `ref/` 任何文件 |
| **允许的补测** | 用仓库内只读副本 `ref/CPU` **同器件/同工具/同约束**复测（本轮即此路径），并在报告中标注"**本轮实测**"而非"引用大三报告" |

### 4.3 对比表（报告核心表，三项分列）

**表 1 · 结构层（同频、与频率无关）**

| 程序 | 单周期拍数（当前基线） | 单周期 CPI | 流水线 `C_steady` | 流水线 `CPI_steady` | 结构加速比 = `IC_useful/C_steady` |
|---|---|---|---|---|---|
| test0 / test1 / sort | 大三数据（同源镜像） | **1.00** | 本轮实测 | 本轮实测 | `IC_useful/C_steady` |

**表 2 · 时序与资源层（大三实测数据）**

| 设计 | LUT | FF | BRAM | Fmax (MHz) | 数据来源 |
|---|---|---|---|---|---|
| 单周期（大三） | 大三数据 | 大三数据 | 大三数据 | 大三数据 | 注明报告章节 |
| 流水线（本轮） | 本轮综合 | 本轮综合 | 本轮综合 | 本轮综合 | 本轮综合报告 |

**表 3 · 系统层（合成结论）**

| 项 | 公式 | 结果 |
|---|---|---|
| 结构加速比 `S_struct` | `IC_useful / C_steady` | < 1（属预期） |
| 频率加速比 `S_freq` | `Fmax_流水线 / Fmax_单周期` | > 1（收益来源） |
| **时间加速比 `S_time`** | `S_struct × S_freq` | **最终答案** |
| MIPS / CPU 时间 | 各自按 100 MHz 与各自 Fmax 双口径 | 表 E 形式 |

### 4.4 降级路径（仅在数据缺失时启用）

| 缺失项 | 处理 |
|---|---|
| 大三 Fmax 未记录 | 报告中留空并注明；**结论只写到结构层**（表 1 已完整可出结论） |
| 大三资源未记录 | 同上；资源对比从报告中移除，不做推测 |
| 大三拍数/运行时间未记录 | 用"单周期 CPI≡1 ⇒ 拍数 = IC"这一**定义**补充（这不是假设，是单周期的定义），并注明"按定义折算" |
| 需要补测才能支撑结论 | **先向组内成员索取更完整的大三原始记录**；确实必要时才考虑同条件复测，且在报告中说明"复测"而非"引用" |

---

## 5. 频率维度（表 E，可选）

流水线的收益体现在频率上，因此给一张**单表**即可：

| 频率 | MIPS | CPU time | 说明 |
|---|---|---|---|
| 100 MHz（名义） | 计算值 | 计算值 | 与大三同频对比用 |
| Fmax_流水线 | 计算值 | 计算值 | 流水线实际可跑频率 |
| Fmax_单周期 | 计算值 | 计算值 | 大三数据 |

> 口径注：本表为 `T = C/f` 的**推算**，非另做多次综合；若 Fmax 缺失则本表退化为单行（100 MHz）。

---

## 6. 报告"性能"章的建议结构（6 节，一页表 + 一段分析）

| 节 | 内容 | 素材 |
|---|---|---|
| 6.1 | 评价指标选择与依据 | §1（三句话依据） |
| 6.2 | 测量方法与口径（窗口/判据/恒等式自检） | §2 |
| 6.3 | 工作负载说明（4 档 + 规模档） | §3 |
| 6.4 | **大三单周期 CPU 简介**（结构 + 工作原理 + 数据通路图） | §4.1 |
| 6.5 | **对比分析**（表 1/2/3 + 结论四条） | §4.3 |
| 6.6 | 结论与改进方向 | 见下 |

**结论四条（固定回答）**：
1. 流水线**稳态 CPI** = ?（区间 + 规模档收敛值），超 1 的部分中 **load-use 冻结占 x%、分支/跳转冲刷占 y%**；
2. **短程序 CPI 偏高**是固定开销（填充 + 停机尾）所致，占 `C_total` 的 ?%（test0）→ 大规模档 <1%；
3. **同频下单周期更快**（CPI≡1）是必然：流水线为频率付出了吞吐代价，结构加速比 = ?；
4. **流水线的收益在频率**：时间加速比 = ?（`S_struct × S_freq`），即"提频收益是否覆盖 CPI>1 的损失"。

---

## 7. 相对 v1.0 被简化掉的部分（避免过度设计）

> v1.0 方案已删除、本文件接替其位置；下表说明本版相对 v1.0 及其修订过程中的取舍。

| 曾考虑项（v1.0 或其修订过程） | 处理 | 理由 |
|---|---|---|
| v2.0 草案的 6 主档 + 3 规模档 | **最终落实为 5 主档 + 3 规模档（共 8 档）** | `instr_cover`/`hazard_cover` 保留用于指令构成与停顿分析，规模档用于 CPI 收敛 |
| 复测 `ref/CPU` 副本综合取 Fmax/资源 | **删掉** | 要求明确"**以组内成员大三阶段的实验数据作为比较基准**"；复测反而偏离要求 |
| `T_branch` / `T_jump` 分类计数 | **保留但可合并** | 保留能让停顿分析"依据充分"；若实现成本高，先合并为 `T`，在分析文字里说明构成 |
| 表 E 频率敏感性 3 点 | **简化为单表（≤3 行）** | 要求未提多频率实测；推算表够用 |
| 三套窗口 + 两条恒等式 | **保留** | 这是"数据真实"的技术保障，且成本低（TB 内计数） |
| 原始 CSV 落 `doc/perf_data/` | **保留** | 重点核查对象，必须可回溯 |
| 单周期拍数单独写 TB 实测 | **删掉**，改用大三数据 + `IC` 定义折算 | 大三数据即基准；同源镜像下拍数 = IC |
| `loop_heavy` 独立新程序 | **已采用**（`N=8/32/128`） | 提供可控的循环规模，避免排序算法干扰趋势 |

**简化后工作量**：TB 加 3 个计数（`C_steady`/`C_fixed`/身份式）+ 1 个规模档 → 约半天；报告"性能"章约 1 页表 + 1 页分析。

---

## 8. 交付物与自检

| # | 交付物 | 验收 |
|---|---|---|
| 1 | `tb_perf.v`（升级：三窗口 + 恒等式 A/B + 规模档） | 8 档全 PASS，恒等式 A/B 全过，`D` 实测一致 |
| 2 | `run_perf.ps1`（升级：8 档汇总） | 打印 `== PERF ALL PASS ==` |
| 3 | 原始数据 `pipeline/doc/perf_data/<日期>_perf_summary.csv` | 报告数字可逐格回溯 |
| 4 | **大三单周期数据引用表**（含出处与条件核对） | 逐项注明来源；不可比项已标注 |
| 5 | `perf_report.md`(v2) | 表 1/2/3 + 结论四条；数据与 CSV 一致 |
| 6 | 流水线侧资源/Fmax（本轮综合一次） | ✅ 已完成，与表 2 同口径 |

**出数前必查**：① 功能回归 21/21 全绿（防止"为快而错"）；② 恒等式 A/B 全 PASS；③ 表内每个数字都能指到 CSV 或大三报告的具体位置。

---

## 9. 变更记录

- **v2.0（2026-09-13）**：按课程要求**重写**。要点：① 明确**指标选择依据**（CPI 为主、IPC 对照、MIPS/CPU 时间只用于频率维度）；② 时间窗口改**三口径**（`C_total`/`C_steady`/`C_fixed`）并加**两条恒等式自检**；③ 负载由 9 档收敛为 **4 主档 + 1 规模档**；④ 对比基线改为**组内成员大三阶段实验数据**（删掉"复测 `ref/CPU` 副本"链路），新增**可比性检查表**与**大三单周期 CPU 结构与工作原理简介**（§4.1）；⑤ 对比结论改为**表 1 结构层 / 表 2 时序资源层 / 表 3 系统层**三层 + 四条固定结论；⑥ 原始 CSV 落 `pipeline/doc/perf_data/` 以供核查。**取代 v1.0**（原 5 档、单窗口、以 `cycles_single = IC` 理论基线对比的口径）。
- **v2.1（2026-09-14）**：完成 8 档复测、两阶段综合与最终报告；修正 `IC` 含停机指令时的稳态口径，新增 `IC_useful=IC-1`，避免 `CPI_steady<1`；`run_perf.ps1` 输出三窗口、两条恒等式和有效指令吞吐指标。
- v1.0（2026-09-06，**已删除**）：5 档程序 + 理论单周期基线；T32/T33 落地记录见 `pipeline/doc/tasks.md` §4 与 `pipeline/doc/perf_report.md`。
