StarryReverie/board/pipeline/doc/sim_shots/exp1/auto/perf_table_20260913.md

# §7 性能测试（5 档 + 恒等式 C == IC + (F−1) + L + 2T）

命令：`powershell -File pipeline/src/scripts/run_perf.ps1`　日期：
20260913
　时钟：100 MHz 名义（Tclk=10 ns）

| 程序 | 静态字数 | IC | C(拍) | L | T | CPI | IPC | CPU time(ns) | MIPS | 恒等式 |
|---|---|---|---|---|---|---|---|---|---|---|
| test0 | 10 | 10 | 12 | 0 | 1 | 1.2 | 0.833 | 120 | 83.3 | PASS |
| test1 | 21 | 19 | 24 | 1 | 2 | 1.263 | 0.792 | 240 | 79.2 | PASS |
| sort | 36 | 177 | 247 | 10 | 30 | 1.395 | 0.717 | 2470 | 71.7 | PASS |
| cover | 36 | 33 | 43 | 0 | 5 | 1.303 | 0.767 | 430 | 76.7 | PASS |
| hazard | 17 | 16 | 22 | 2 | 2 | 1.375 | 0.727 | 220 | 72.7 | PASS |

恒等式 **5/5 PASS**；每档内嵌正确性断言全绿（防“为快而错”）。
