StarryReverie/board/pipeline/doc/sim_shots/exp1/auto/1_pipe_overview_20260913.png

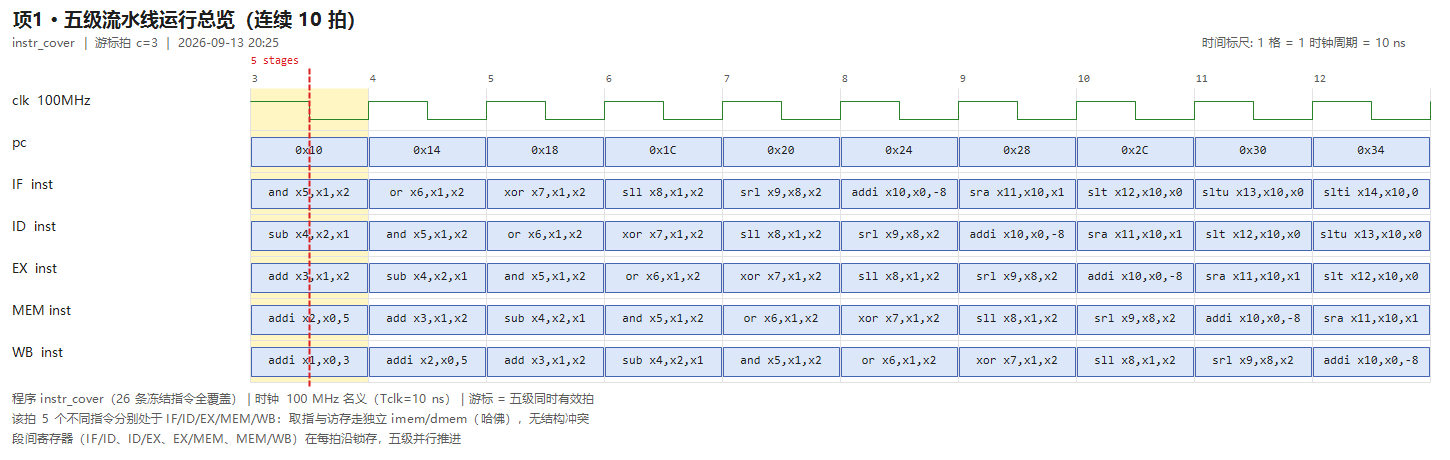
pipeline/doc/sim_shots/exp1/auto/1_pipe_overview_20260913.png
