StarryReverie/board/pipeline/doc/sim_shots/exp1/auto/2_fwd_priority_20260913.png

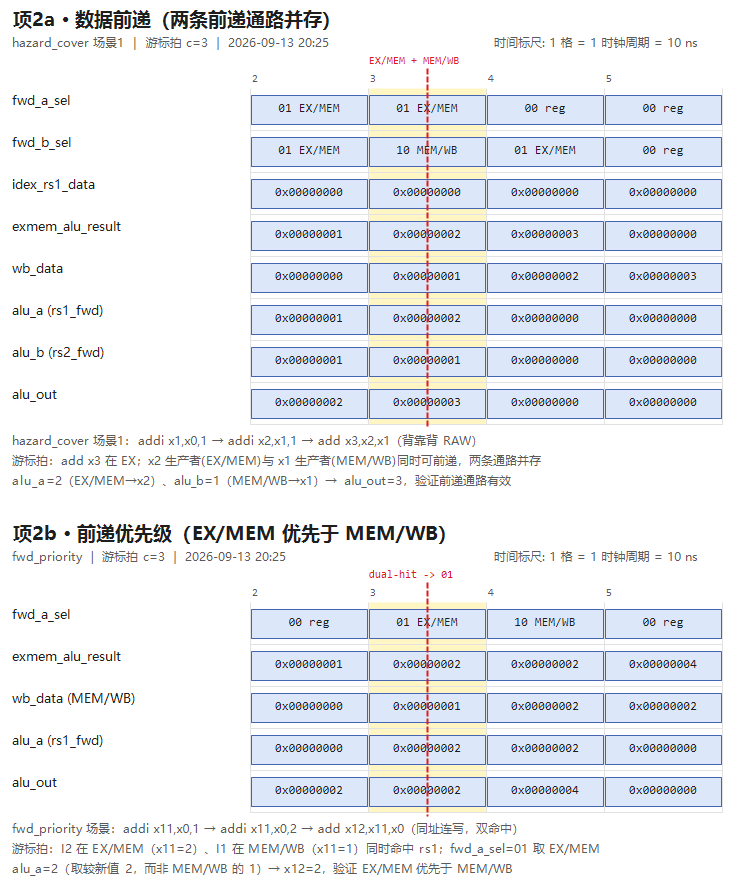
pipeline/doc/sim_shots/exp1/auto/2_fwd_priority_20260913.png
