StarryReverie/board/pipeline/doc/sim_shots/exp1/auto/3_loaduse_stall_20260913.png

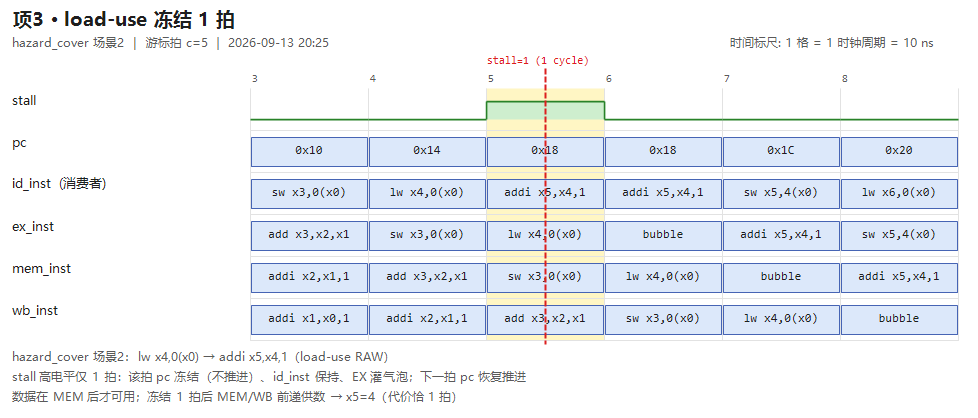
pipeline/doc/sim_shots/exp1/auto/3_loaduse_stall_20260913.png
