StarryReverie/board/pipeline/doc/sim_shots/exp1/auto/4_branch_flush_20260913.png

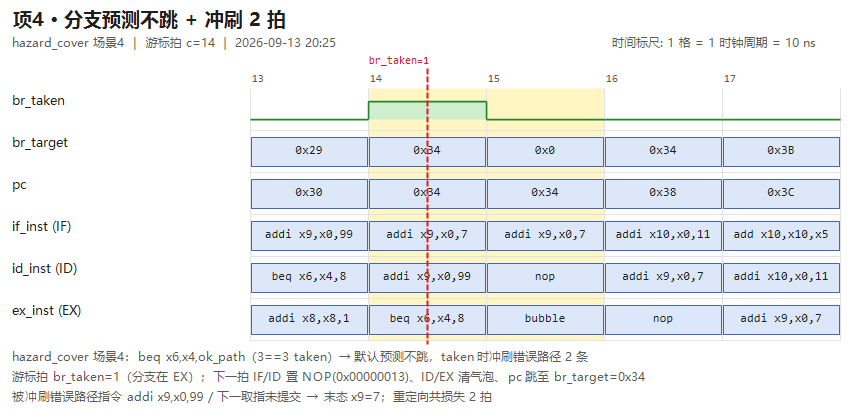
pipeline/doc/sim_shots/exp1/auto/4_branch_flush_20260913.png
