StarryReverie/board/pipeline/doc/sim_shots/exp1/auto/perf_table_20260913.png

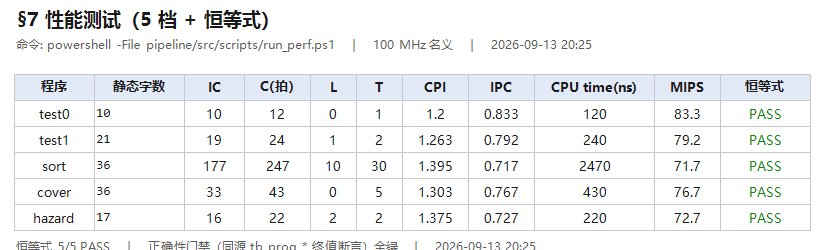
pipeline/doc/sim_shots/exp1/auto/perf_table_20260913.png
