StarryReverie/board/pipeline/doc/sim_shots/exp1/auto/reg_summary_20260913.png

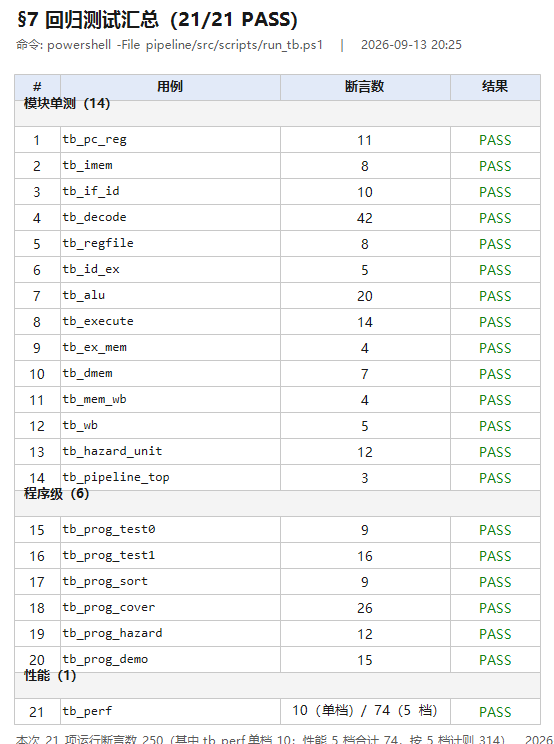
pipeline/doc/sim_shots/exp1/auto/reg_summary_20260913.png
