StarryReverie/board/pipeline/doc/sim_shots/exp1/数据前递.png

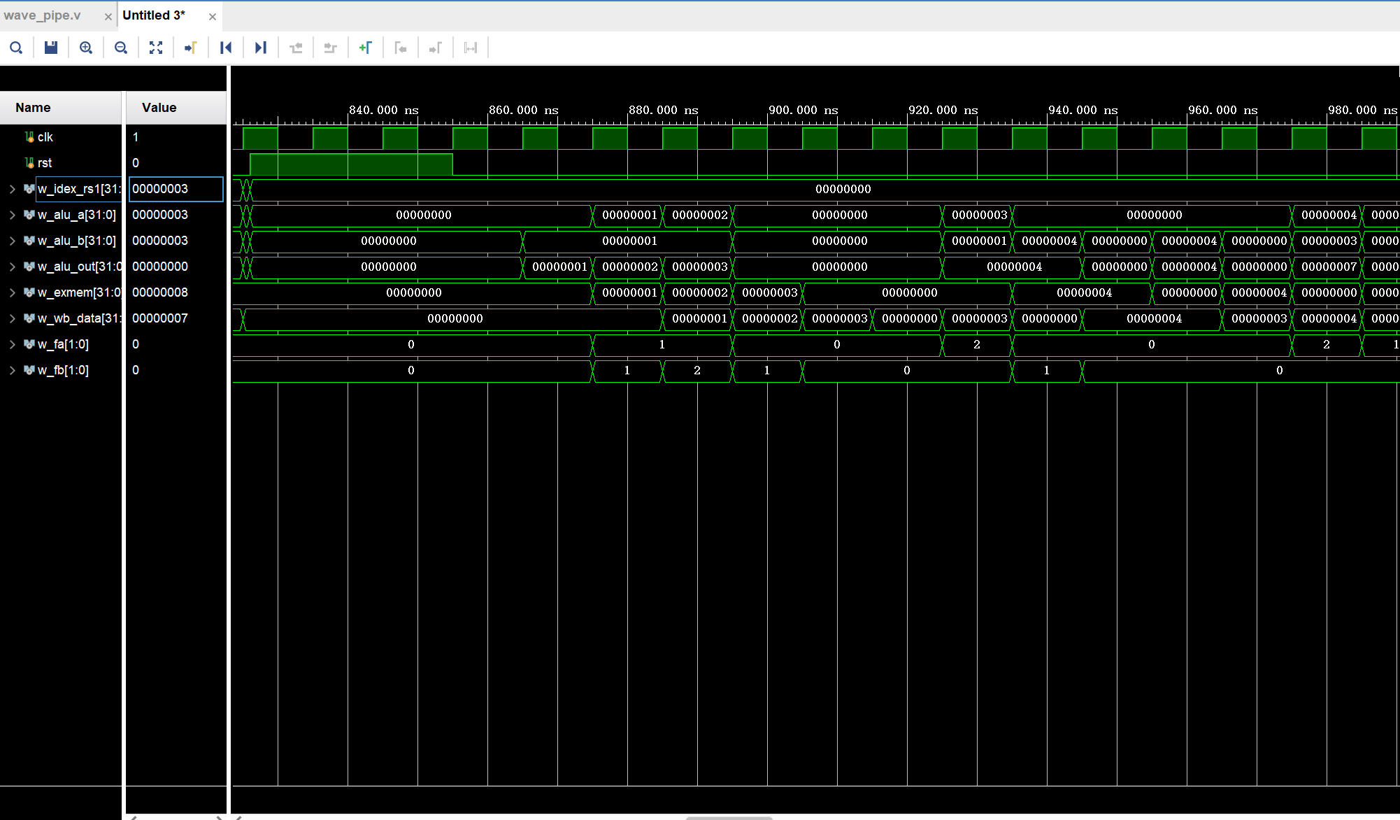
pipeline/doc/sim_shots/exp1/数据前递.png
