StarryReverie/board/ppt/assets/diagram-addr-map.png

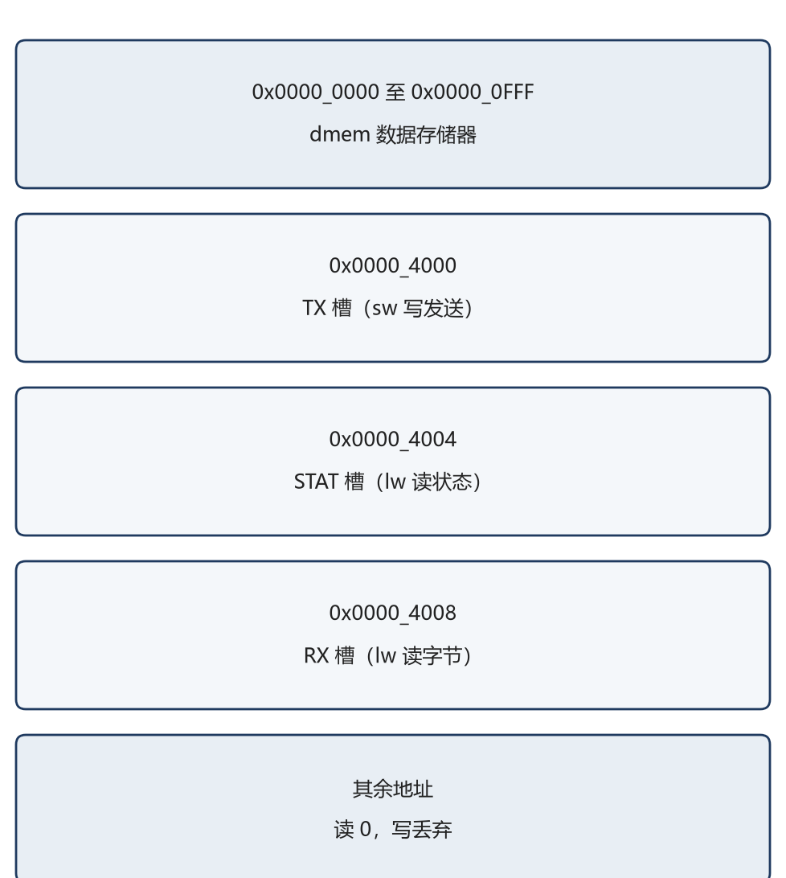
ppt/assets/diagram-addr-map.png
