StarryReverie/board/ppt/assets/diagram-txbusy-timing.png

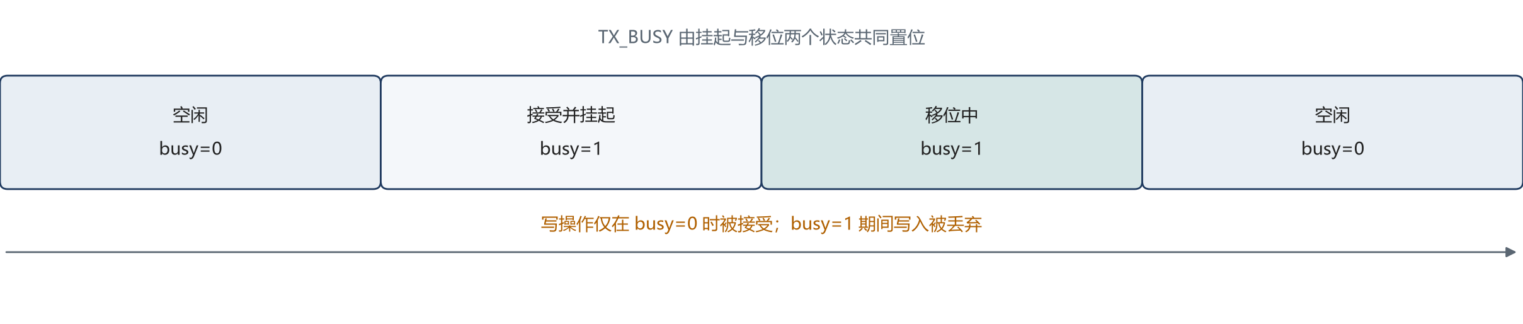
ppt/assets/diagram-txbusy-timing.png
