StarryReverie/board/soc/doc/sim_shots/exp2/2a_rx_in_tolerance_20260915.png

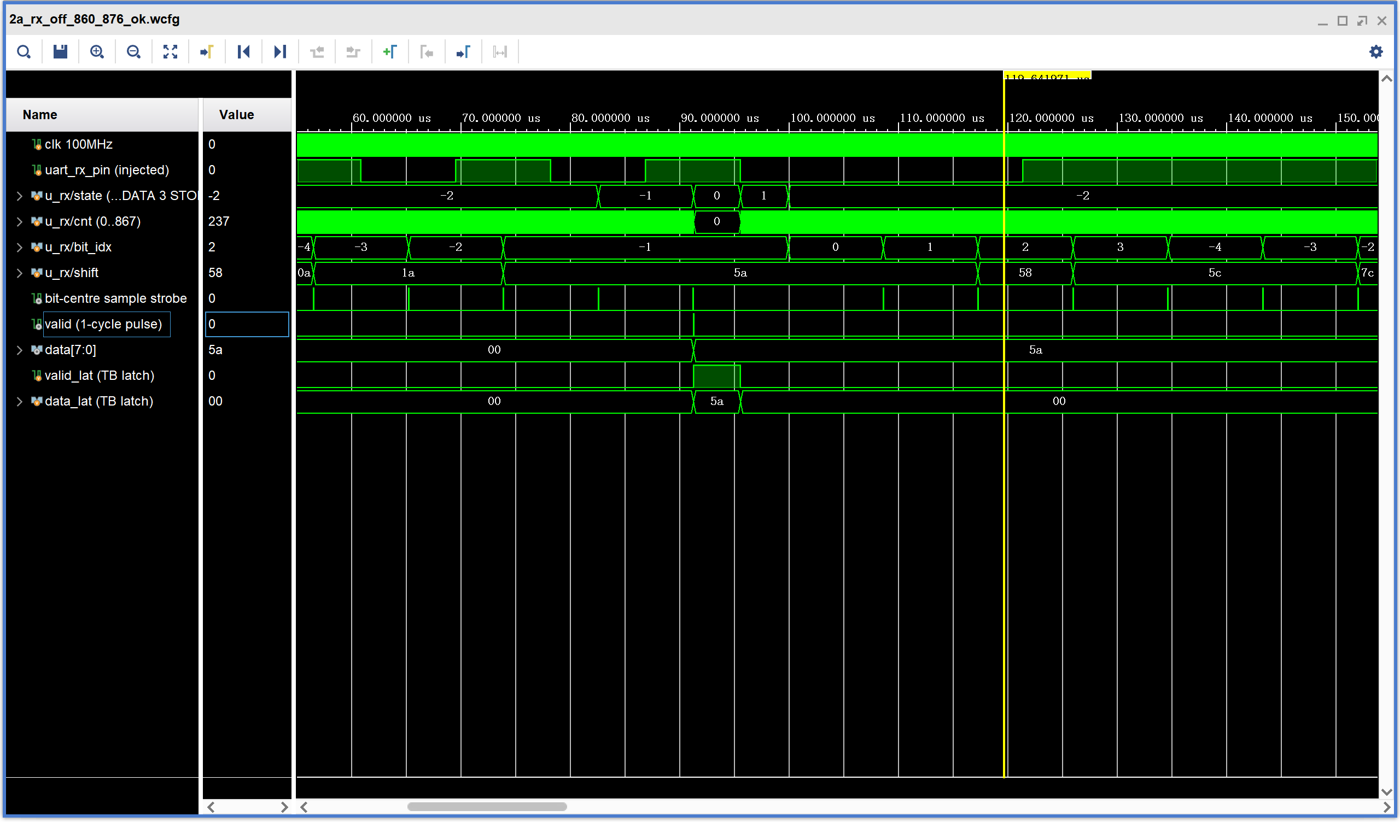
soc/doc/sim_shots/exp2/2a_rx_in_tolerance_20260915.png
