StarryReverie/board/soc/doc/sim_shots/exp2/2b_rx_glitch_rejected_20260915.png

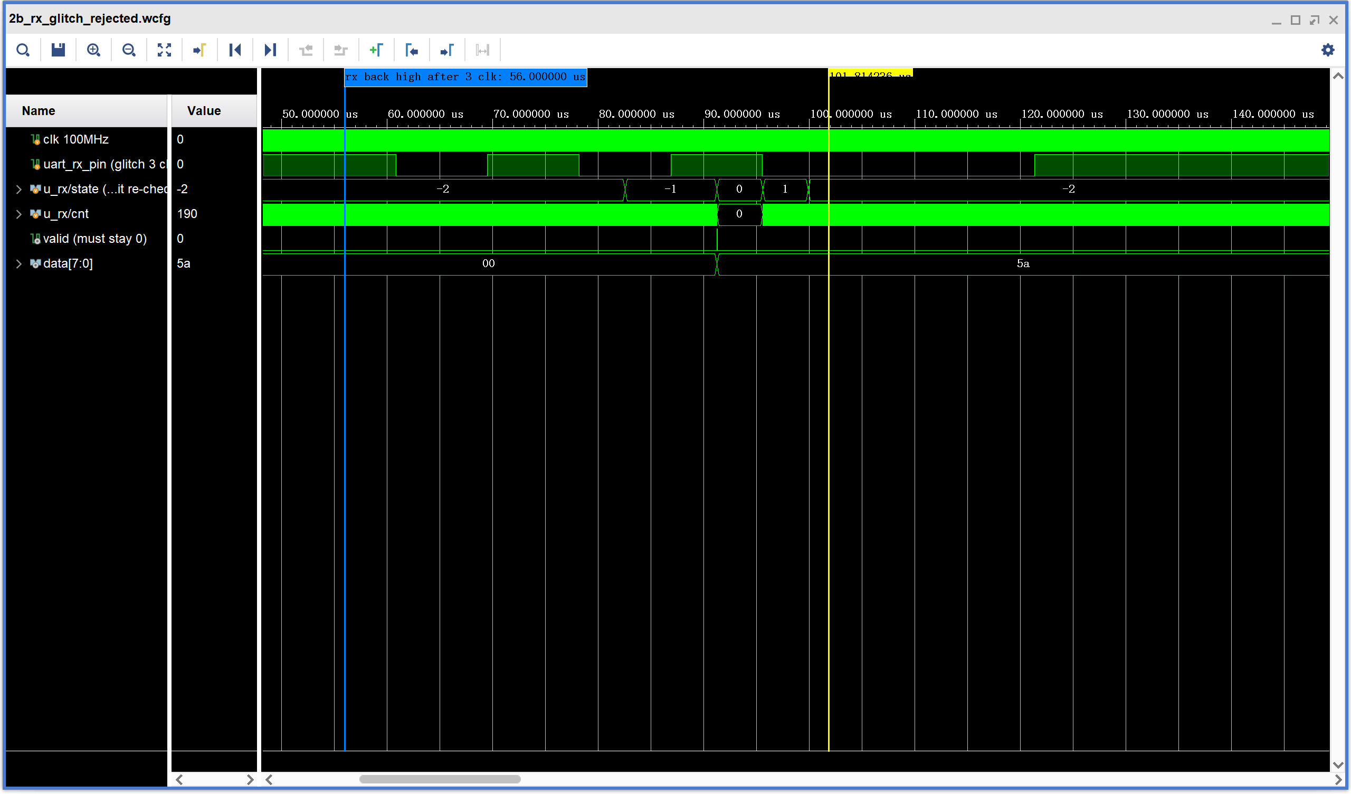
soc/doc/sim_shots/exp2/2b_rx_glitch_rejected_20260915.png
