StarryReverie/board/soc/doc/sim_shots/exp2/2c_rx_badstop_discarded_20260915.png

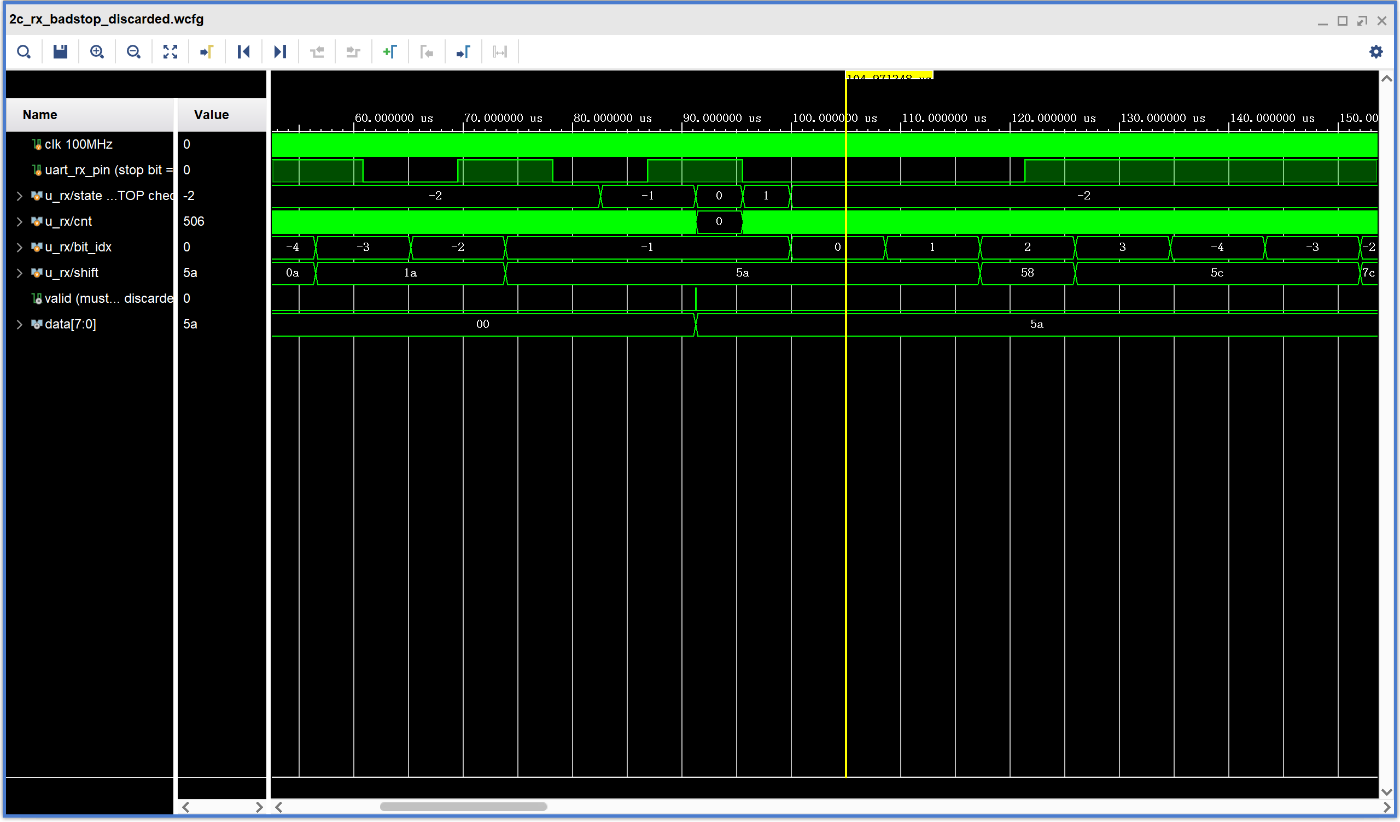
soc/doc/sim_shots/exp2/2c_rx_badstop_discarded_20260915.png
