StarryReverie/board/soc/doc/sim_shots/exp2/2d_rx_off_30pct_wrong_20260915.png

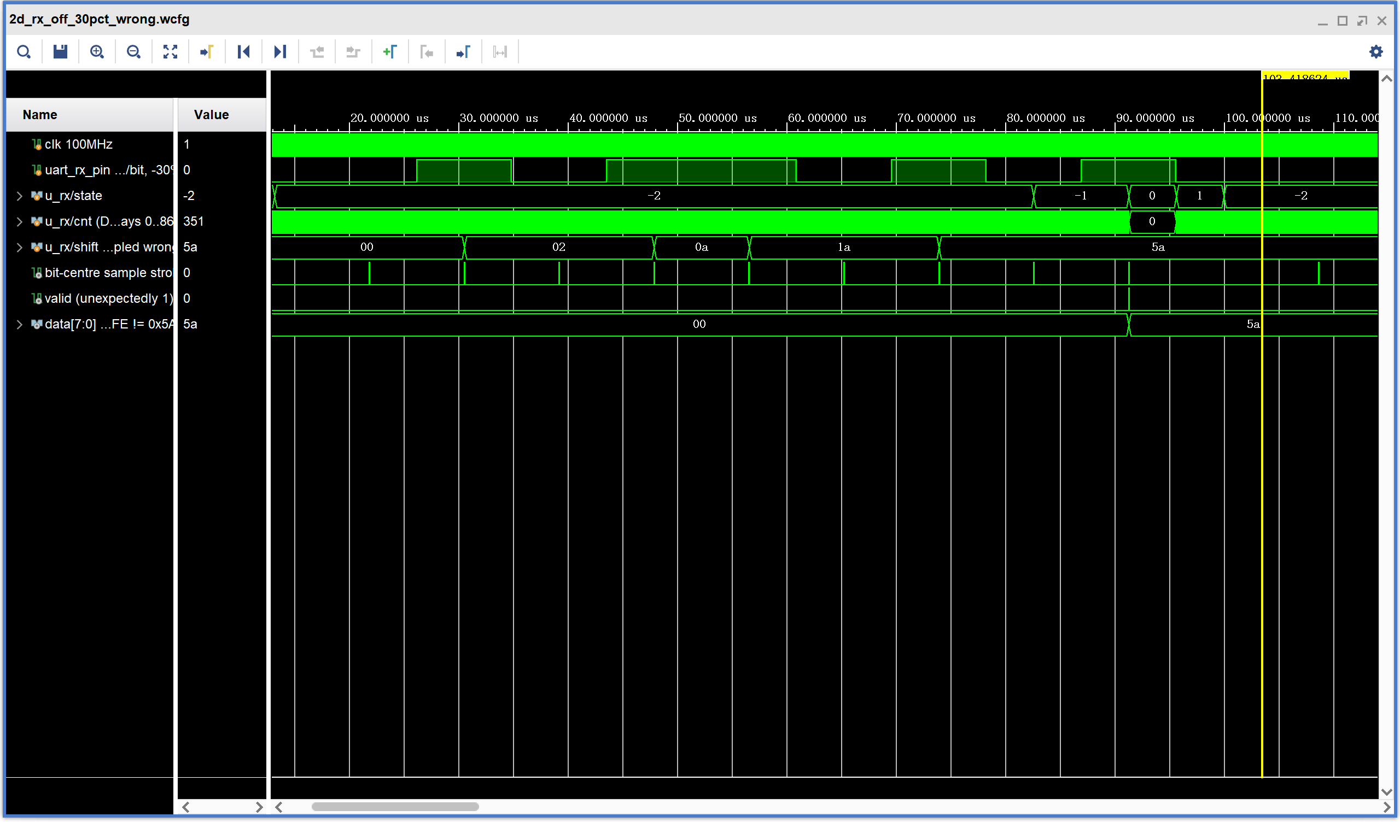
soc/doc/sim_shots/exp2/2d_rx_off_30pct_wrong_20260915.png
