StarryReverie/board/soc/doc/sim_shots/exp2/3a_duplex_overlap_20260915.png

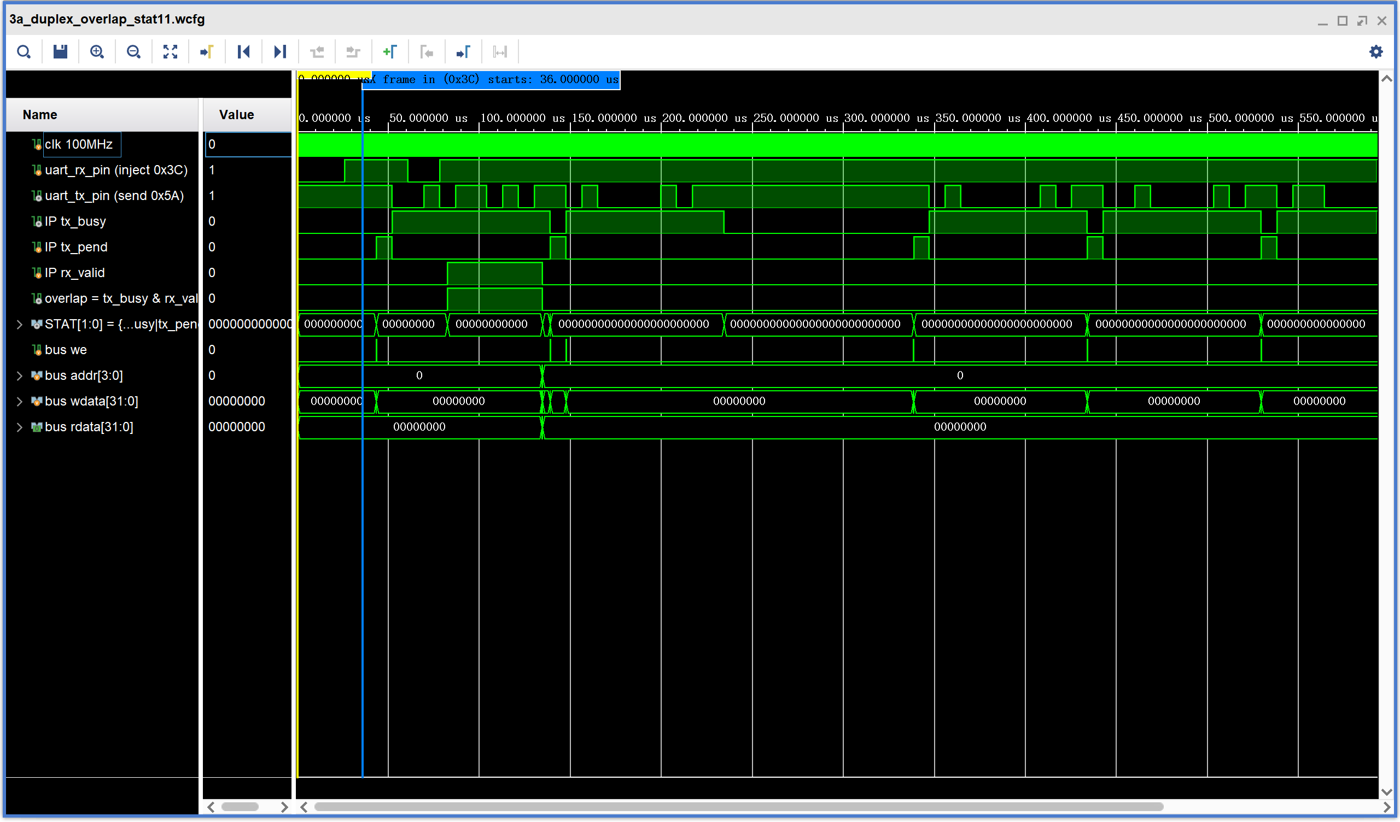
soc/doc/sim_shots/exp2/3a_duplex_overlap_20260915.png
