StarryReverie/board/soc/doc/sim_shots/exp2/3c_putc_consecutive_20260915.png

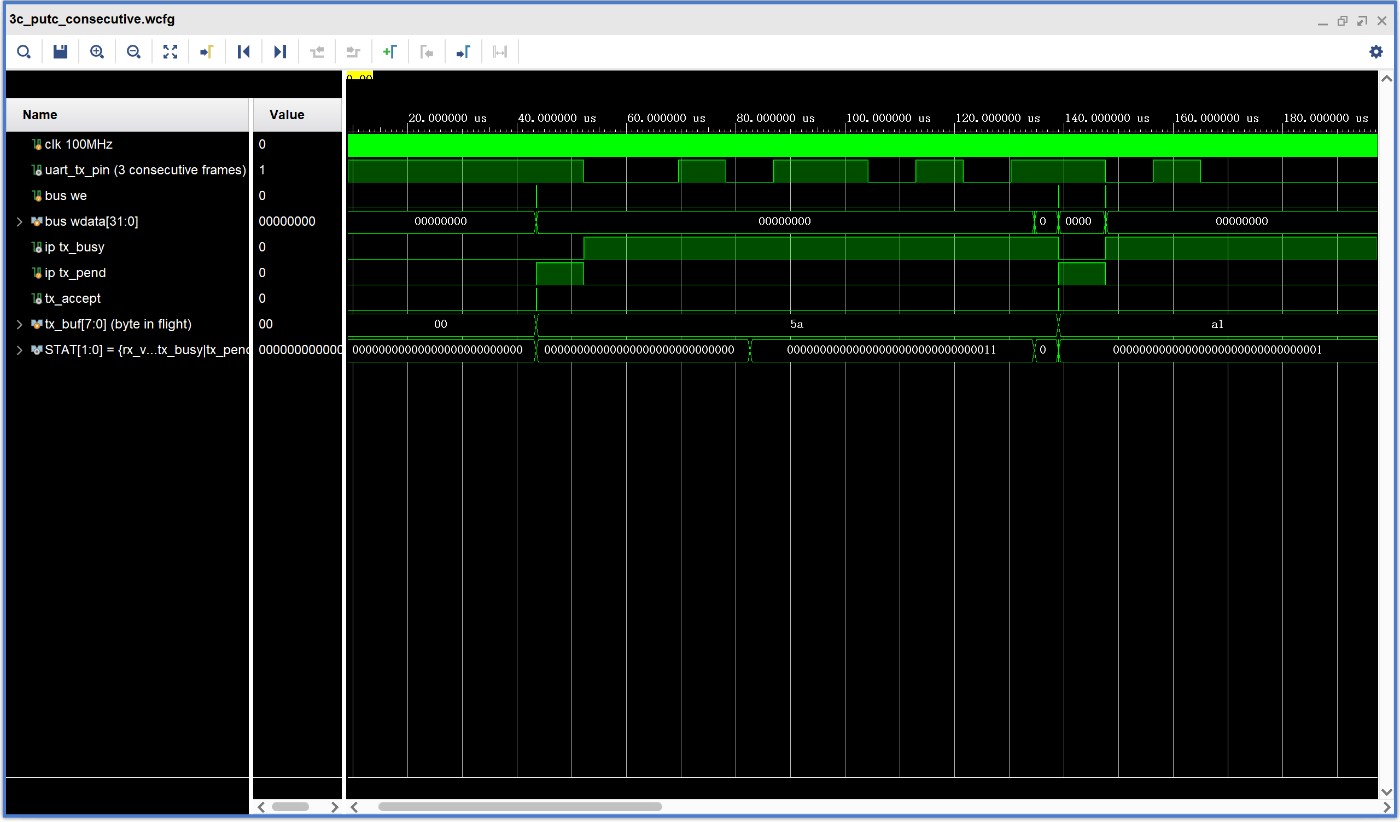
soc/doc/sim_shots/exp2/3c_putc_consecutive_20260915.png
