StarryReverie/board/soc/doc/sim_shots/exp2/4a_mmio_stat_poll_sw_tx_20260915.png

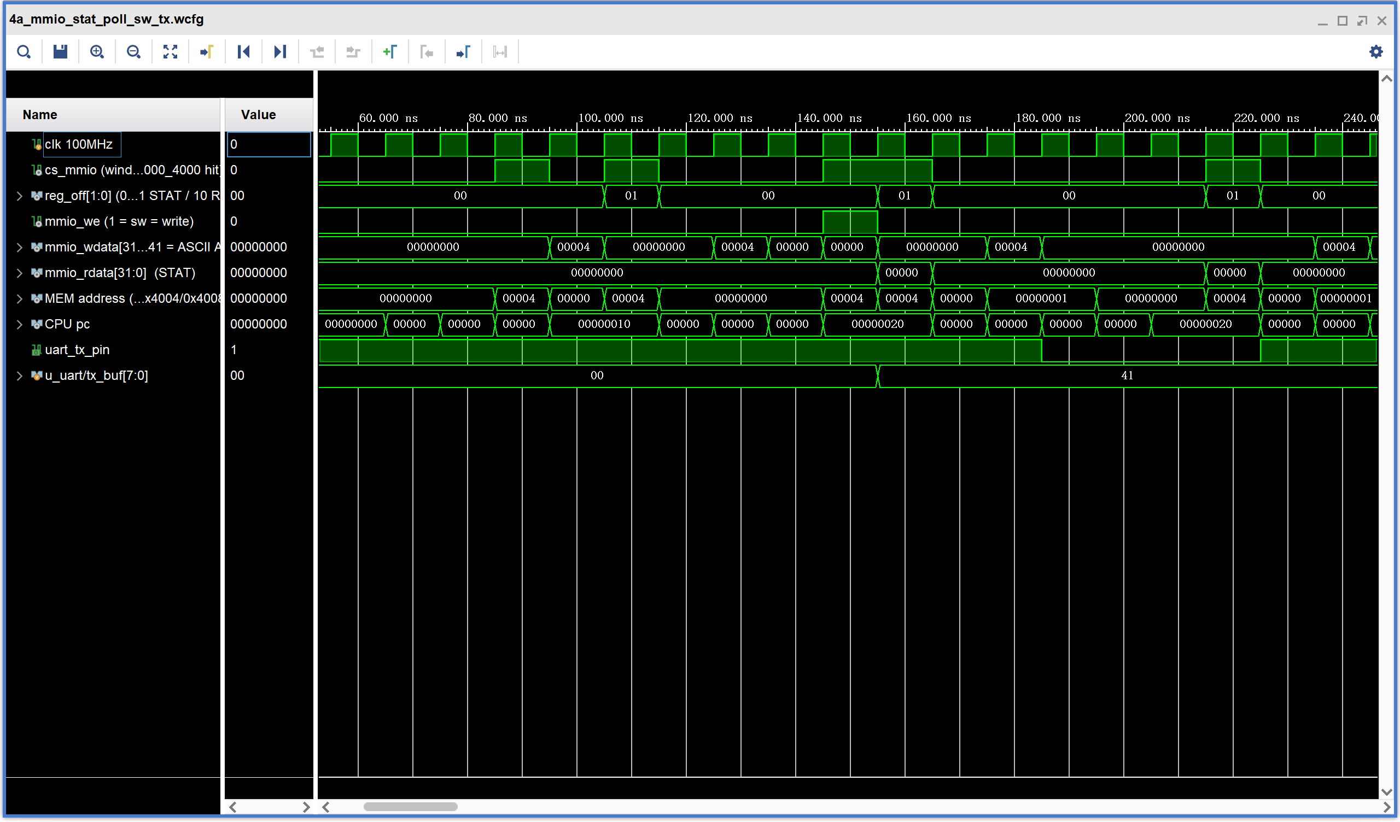
soc/doc/sim_shots/exp2/4a_mmio_stat_poll_sw_tx_20260915.png
