StarryReverie/board/soc/doc/sim_shots/exp2/4c_mmio_rx_read_sw_echo_20260915.png

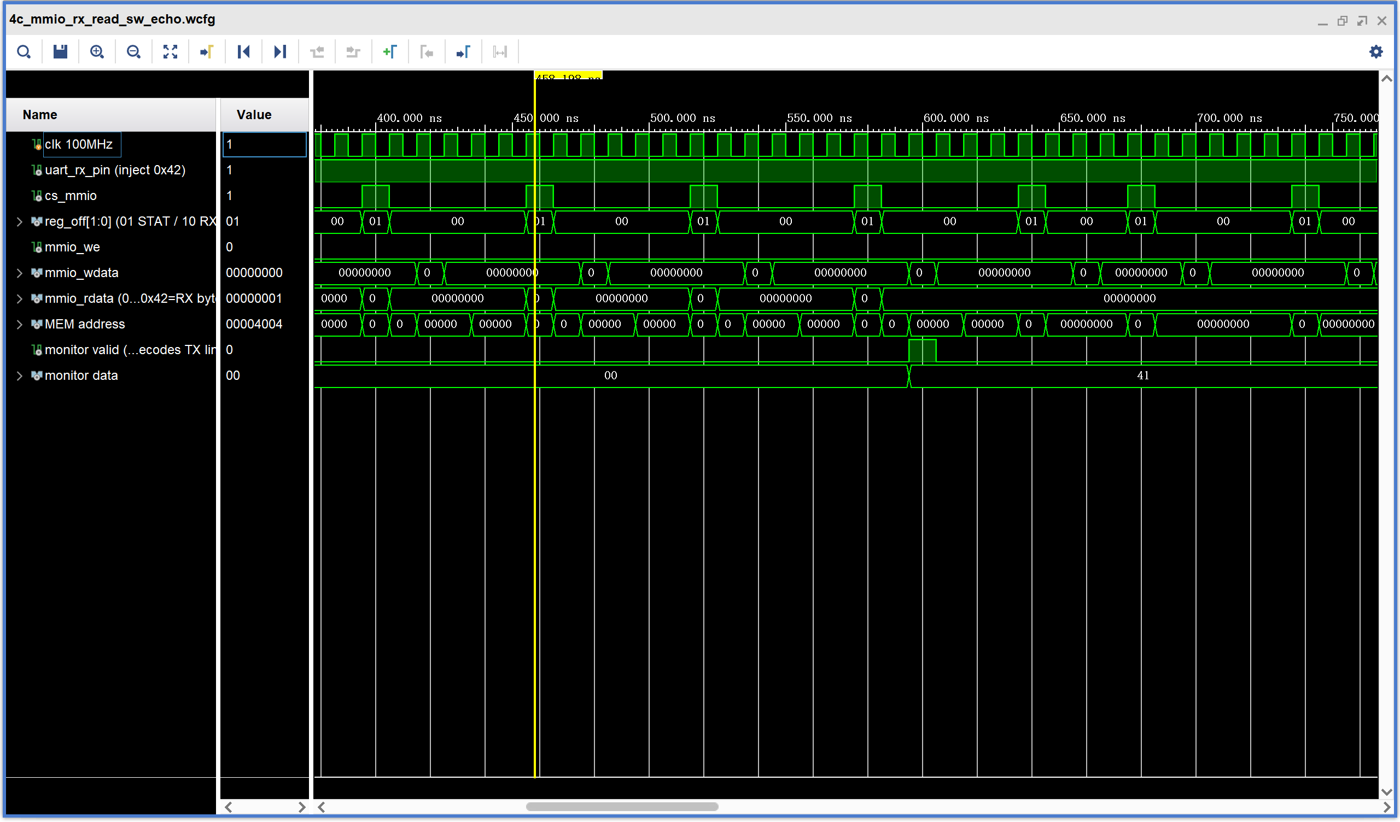
soc/doc/sim_shots/exp2/4c_mmio_rx_read_sw_echo_20260915.png
