StarryReverie/board/soc/doc/sim_shots/exp2/4d_echo_frame_0x42_20260915.png

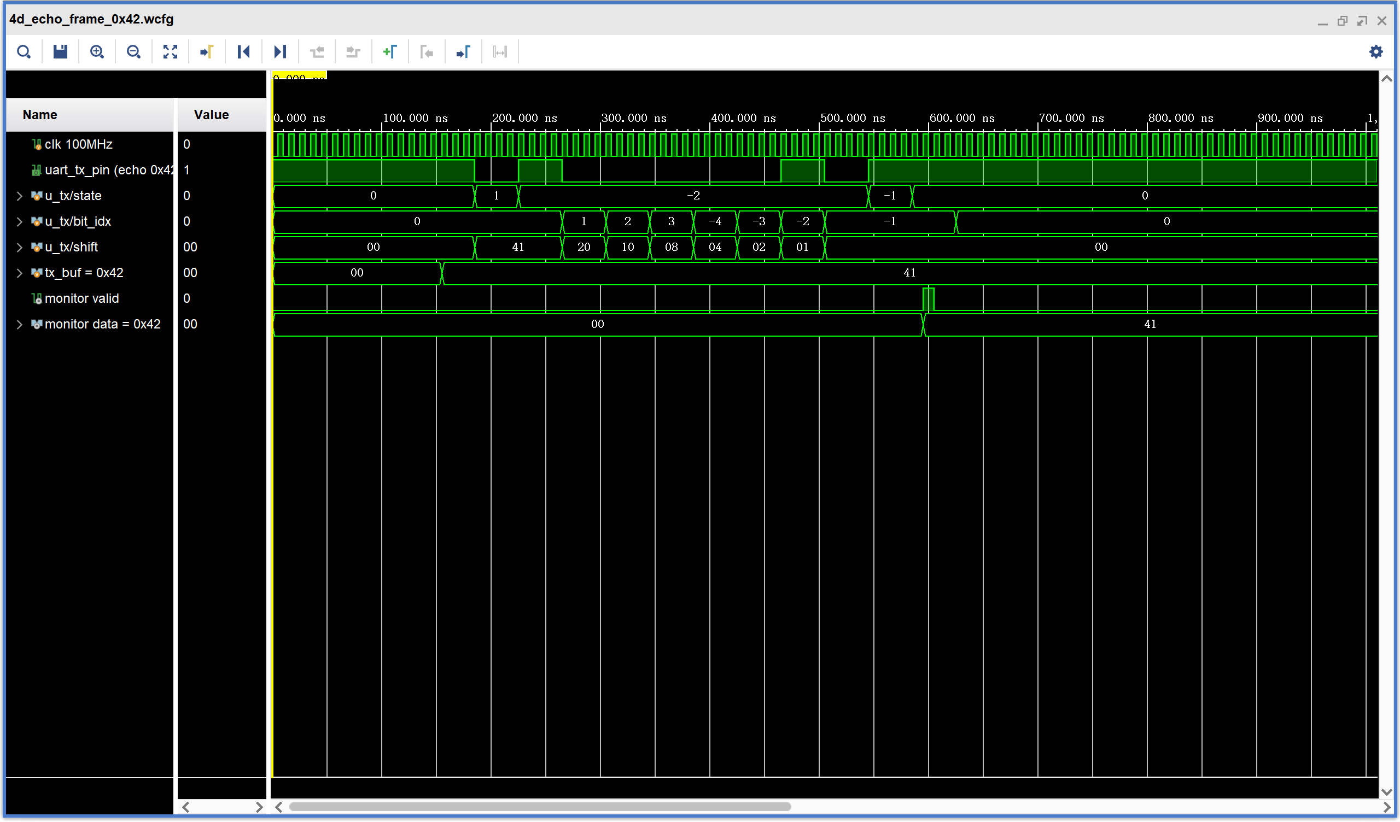
soc/doc/sim_shots/exp2/4d_echo_frame_0x42_20260915.png
