StarryReverie/board/pipeline/src/defines/const_define.v

//=============================================================================
// const_define.v — 计组实验一常量宏
//   - ALU 操作码 / 标志位位号 / 立即数格式沿用 ref/CPU/defines/const_define.v
//   - 新增：存储规模（IMEM_WORDS/DMEM_WORDS）、NOP 指令编码
//   - 修改须先改 pipeline/doc/top_design.md §2/§6 与 pipeline/doc/isa.md 并登记变更记录
//=============================================================================
`ifndef CONST_DEFINE_V
`define CONST_DEFINE_V

//------------------------------- ALU 操作码 [3:0] ----------------------------
`define ALU_ADD  4'b0000
`define ALU_SUB  4'b0001
`define ALU_SLT  4'b0010
`define ALU_AND  4'b0011
`define ALU_OR   4'b0100
`define ALU_XOR  4'b0101
`define ALU_SLL  4'b0110
`define ALU_SRL  4'b0111
`define ALU_SRA  4'b1000
`define ALU_SLTU 4'b1001

//------------------------------- 标志位位号（flags[4:0]） ---------------------
// flags = {ZF,SF,CF,OF,PF}（alu 输出，33 位进位结果产生 CF/OF）
`define ZF 4      // 零标志
`define SF 3      // 符号标志
`define CF 2      // 进位/借位
`define OF 1      // 溢出（附加功能"溢出判断"）
`define PF 0      // 奇偶标志

//------------------------------- 立即数格式选择 ------------------------------
`define IMM_I  3'b001    // I 型
`define IMM_S  3'b010    // S 型
`define IMM_B  3'b011    // B 型
`define IMM_U  3'b100    // U 型
`define IMM_J  3'b101    // J 型

//------------------------------- 存储规模（top_design §6） --------------------
// 容量可参数化：仿真/契约默认 1024 字=4KB×2；**下板 build 缩容为
// IMEM 128 字=512B、DMEM 64 字=256B**（2026-09-07 上板实测通过）。
// 容量选型依据（组合读寄存器阵列）：
//   早期按**用户手册误标**的 XC7A35T 资源估算：4KB×2=65k FF 超 41.6k FF；
//   1KB×2 组合读逻辑 ≈35.5k LUT 超 20.8k LUT；
//   **实物 JTAG idcode 实测为 XC7A100T（63.4k LUT / 126.8k FF）**，故上述容量
//   本身并非硬约束——真正的硬约束是 Vivado 2019.2 在 4KB×2 组合读阵列下的
//   "器件加载阶段空转"（见 UART/doc/tasks.md 已知限制表）；
//   本工程上板统一取 512B/256B（IMEM 128 字 / DMEM 64 字），资源与实现开销均收敛。
// **地址索引固定 addr[11:0]**：本参数化只支持 ≤4KB 缩容场景，不可扩容。
// 覆盖方式：综合缩容**至少**覆盖 IMEM_BYTES/DMEM_BYTES；IMEM_WORDS/DMEM_WORDS
// 当前仅用于口径/文档说明（xvlog 宏体内不递归展开，BYTES 无法由 WORDS 派生）。
`ifndef IMEM_WORDS
`define IMEM_WORDS 1024   // 指令存储字数（×32bit，默认 4KB）
`endif
`ifndef DMEM_WORDS
`define DMEM_WORDS 1024   // 数据存储字数（×32bit，默认 4KB）
`endif
`ifndef IMEM_BYTES
`define IMEM_BYTES (1024*4)   // 综合缩容必配；WORDS 当前仅作口径说明
`endif
`ifndef DMEM_BYTES
`define DMEM_BYTES (1024*4)   // 综合缩容必配；WORDS 当前仅作口径说明
`endif

//------------------------------- 杂项 ----------------------------------------
`define INST_NOP 32'h00000013  // nop = addi x0,x0,0（if_id 冲刷 / 气泡填充值）

`endif // CONST_DEFINE_V
