StarryReverie/board/pipeline/src/test/loop_heavy_128.asm

# loop_heavy: dynamic-IC load tier for perf_analysis v2.1 sec.3
# body per iteration: lw-add-sw-lw-add-sw + backward bne (taken)
#   -> 2 load-use stalls; the backedge redirects N-1 times (terminal iteration excluded)
# expected for N=128: x8=16640 dmem0=129 dmem4=130
    addi x1, x0, 1
    sw   x1, 0(x0)
    addi x1, x0, 2
    sw   x1, 4(x0)
    addi x8, x0, 0
    addi x5, x0, 128
loop:
    lw   x6, 0(x0)
    add x8, x8, x6
    addi x6, x6, 1
    sw   x6, 0(x0)
    lw   x7, 4(x0)
    add x8, x8, x7
    addi x7, x7, 1
    sw   x7, 4(x0)
    addi x5, x5, -1
    bne  x5, x0, loop
halt:
    beq  x0, x0, halt
