StarryReverie/board/pipeline/src/test/test0.asm

# ==================================================================
# test0.asm — 由 ref/CPU/test/test0.asm 迁移（流水线工程）
# 指令集口径：pipeline/doc/isa.md（26 条冻结）
# 注：ori 按规范符号扩展（imm 均为正小立即数，结果与单周期零扩展一致）
# ==================================================================
# 期望终值：x1=1 x2=2 x3=3 x4=1 x5=3 x6=1 x10=0x10
#           mem[4]=3、mem[0x10]=1（字，小端）
    ori x1, x0, 0x001
    ori x2, x0, 0x002
    ori x10, x0, 0x010

    add x3, x1, x2
    sub x4, x2, x1

    sw x3, 4(x0)
    sw x4, 0(x10)

    lw x5, 4(x0)
    lw x6, 0(x10)

end:
    beq x0, x0, end
