StarryReverie/board/(commit log)

2026-09-02 同步待审查的文档
2026-09-02 添加参考资料
2026-09-02 添加参考资料及审查isa.md
2026-09-04 实现整个项目的顶层设计，明确实验一实验二的集成方案，简化文档
2026-09-04 实验二模型定稿: 统一编址 MMIO(方案B)+UART全双工+程序固化单程序模型
    - top_design v1.4: loader 在线重载搁置, 程序 .vh 固化/换程序重烧, soc_top 去 loader
    - uart_ctrl 全双工定稿: MMIO 窗口 0x4000 TX/STAT/RX 槽位义, EES-338 引脚 T5/T4/N5/P15
    - isa v1.3: §4 补 MMIO 统一编址映射(lw=in/r, sw=out/w, 不加指令)
    - tasks §6 改版 T40-T44 (取消 loader, 新增全双工/回显固件/下板任务)
    - dbus_decode/imem/pipeline_top 模块文档同步, future_extensions 标注搁置
2026-09-04 exp2: 新增汇编实验(UART SoC)代码目录与配套文档集
    - 仿 board/doc 体系建 exp2/doc: require/tasks(U10-U41)/top_design/interface/firmware/ref_note/future_extensions/modules
    - 口径对齐: 全双工 UART 8N1@115200, 统一编址 MMIO 方案B(0x4000 TX/STAT/RX, lw=in/r sw=out/w), 程序固化单程序模型, EES-338(T5/T4/N5/P15)
    - 根目录原 汇编实验设计方案.md(v1.0/v1.1) 内容全部并入本目录文档后删除
2026-09-04 计组实验一 CPU core 编码完成: 14 RTL 模块 + 14 单测全 PASS + 运行脚本
    - RTL: pc_reg/imem/if_id/decode/regfile/id_ex/execute(+alu)/ex_mem/dmem/mem_wb/wb/hazard_unit/pipeline_top
    - defines: instr_define(26条)/const_define 宏(含 IMEM/DMEM_WORDS、INST_NOP)
    - 单测: 模块级 13 份 + 整机冒烟(tb_pipeline_top: 前递/load-use/分支跳转探针) 全绿(本机 Vivado 2019.2 xsim)
    - 修复: 顶层 br_target 误声明 1bit 致分支目标截断; xvlog/xelab/xsim 需 call 调用
    - 工具: scripts/run_tb.ps1(批量 xsim 运行器), scripts/synth_check.tcl(综合自检)
    [alu.v, const_define.v, decode.v, dmem.v, ex_mem.v, execute.v, hazard_unit.v, id_ex.v]
2026-09-04 scripts: synth_check 加 exit、注释报表阶段卡死问题（综合通过判据=无 ERROR 收尾）
2026-09-04 T31 程序回归: test0/test1/sort 迁移 asm+hex+程序TB，机器码与参考工程逐字节一致
    - scripts/build_asm.ps1: riscv-none-elf-as -march=rv32i -> objcopy -O verilog -> *_rom.hex（工具链已本地化，替代 musl-as）
    - test/test0|test1|test_sort.asm(+_rom.hex): 迁移自 ref/CPU/test，含注释预期
    - 程序级 TB: tb_prog_test0/test1/sort（ 载 hex、HALT 区内固定周期采样比对）
    - run_tb.ps1: 仿真前自动拷贝 .hex 到运行目录
    - 回归 17/17 PASS
2026-09-04 T31 收尾: instr_cover(26条全覆盖)/hazard_cover 程序回归 + 文档工具链与 HALT 口径回写
    - instr_cover.asm: 26 条指令全覆盖(含 sll/sltu/srai/lui/jal/jalr 等)，哨兵寄存器验证跳转跳过
    - hazard_cover.asm: 连续RAW/load-use/双load/分支用前递值 五场景
    - TB: tb_prog_cover/tb_prog_hazard；回归 19/19 PASS
    - 文档: 工具链 musl-as -> riscv-none-elf-as(本地化, 产物逐字节一致); HALT 判停口径改固定周期采样(not-taken 预测下 PC 周期往复)
2026-09-04 重构: RTL 移入 rtl/ 子目录，根目录整洁；Vivado/脚本以仓库根为 include 目录不受影响
    - git mv 14 个 RTL -> rtl/（保留历史）
    - run_tb.ps1/synth_check.tcl 指向 rtl/；include_dirs=仓库根使 include defines 照常解析
    - 文档布局口径更新（top_design/tasks/modules*14/exp2 侧）；synth teardown 空转注记
    - 验证: 回归 19/19 PASS；Vivado 综合从 rtl/ 读入并 Finished Synthesize（无 ERROR）
    [alu.v, decode.v, dmem.v, ex_mem.v, execute.v, hazard_unit.v, id_ex.v, if_id.v]
2026-09-04 重构: 代码目录统一收拢到 src/（rtl/defines/test/scripts），exp2 独立留在根
    - 脚本根路径自洽（$root=src），include 目录=src，零脚本改动
    - 回归 19/19 PASS（src/ 布局下重跑）
    - 文档布局口径/模块路径/exp2 引用同步为 src/ 前缀
    - README 增加目录结构与上手说明
2026-09-04 修正: 仿真输出目录 src/scripts/out 移出版本库（.gitignore 增加 src 级模式）
2026-09-04 Vivado: 生成可直接打开的 board.xpr 工程 + 可重建生成脚本
    - src/scripts/create_vivado_proj.tcl: 生成 board/vivado/board.xpr
    （part=xc7a35tcsg324-1; 设计源 src/rtl top=pipeline_top; 仿真源 src/test
    top=tb_pipeline_top; include 目录=src(VerilogDir=$PPRDIR/../src); 原位引用不拷贝）
    - 工程文件路径全部相对化（可整体移植）
    - .gitignore 忽略 vivado/（工程本地生成物）；README 增 GUI 打开/重建说明
2026-09-05 exp2: 实验2代码开工——目录规范对齐实验1 + 首个模块 uart_tx 全绿
    - 目录: exp2/src/{rtl,test,scripts,xdc}（参考实验1 src/ 规范）
    - 工具: exp2/src/scripts/run_tb.ps1（自定位运行器，用法同实验1）
    - 文档: exp2 全系路径口径统一为 src/...（tasks/top_design/modules×5/firmware/README）
    - 代码: src/rtl/uart_tx.v（8N1 发送 FSM：每 clk_en 脉冲推进一位，
    忙时忽略 start、done 拍输出）+ src/test/tb_uart_tx.v（帧位序逐位断言，
    沿后稳态采样；调试要点：沿前采样读到旧区间）
    - 验证: tb_uart_tx PASS
2026-09-05 修正: exp2 仿真输出目录不入库（gitignore 增加 **/scripts/out/）
2026-09-05 exp2 U11: uart_rx 接收 FSM 完成，收发双测全绿
    - src/rtl/uart_rx.v: 起始位下降沿检测+HALF 中心复检(拒毛刺)/8 数据位中心采样
    (LSB 先 shift[bit_idx])/停止位校验(0=帧错误丢弃)；rx 两拍同步；内部系统时钟
    计数位中心（clk_en 端口保留与 TX 对齐）
    - src/test/tb_uart_rx.v: 正常帧逐位、背靠背、帧错误丢弃后恢复、短毛刺拒绝
    - 调试结论（写入注释）: 停止位=0 错误帧后线路停低，模块会把它当新起始位候选，
    靠起始中心复检拒绝——TB 须立即回空闲电平；另 valid 为 1 拍脉冲，
    TB 用沿后锁存监视器捕获
    - 回归 2/2 PASS（tb_uart_tx + tb_uart_rx）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
2026-09-05 exp2 U12: uart_ctrl MMIO 从机完成，UART IP 三模块全绿
    - src/rtl/uart_ctrl.v: TX/STAT/RX 字槽(契约 interface.md §3)
    * TX: 写接受(忙丢弃)→pend→空闲遇 bit_tick 启动(解决 CPU 单拍写与波特率脉冲不同拍)
    * STAT: 读 bit0 TX_BUSY(组合)/bit1 RX_VALID；RX: 读字节+访存段末沿清位
    * 无 FIFO: RX_VALID 未读期间新字节丢弃；clk_en 分频在内部
    - src/test/tb_uart_ctrl.v: 槽默认读0/触发发送/busy翻转/忙写丢弃(无第二帧)/
    收字节+读清位/溢出保留首字节/写STAT与RX无操作
    - 排障: Verilog task 形参 input maxcyc 未指定位宽=1bit(80→0 循环不执行)——
    等待类任务统一用 [15:0]；事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
2026-09-05 T40: dbus_decode 落地 + pipeline_top 实验二 build(SOC_BUILD) 双态验证
    计组侧:
    - src/rtl/pipeline_top.v: 参数 SOC_BUILD(默认0=实验一不变)
    * SOC=1: MEM 段例化 dbus_decode(代码在 exp2/src/rtl)，rdata 经 mux 入 mem_wb，
    dmem 写门控 we&cs_dmem，mmio 总线穿出(we 亦门控)
    * SOC=0: dmem 直连、mmio 恒 0（回归 H1-H5 不变）
    exp2 侧:
    - src/rtl/dbus_decode.v: 低区<4096→dmem；窗口 0x4000(+0/4/8 槽 reg_off=addr[3:2])→mmio；其余读0
    - src/test/tb_dbus_decode.v: 分区/槽/越界/mux 全断言
    - src/test/tb_pipe_soc.v: SOC 整机验证——写 TX(哑从机捕获)、读 STAT=0xCD、
    读 TX=0、dmem 侧 sw/lw 正常
    - 运行器: 编译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
2026-09-05 exp2 U14: reset_sync + soc_top 装配完成——整机系统级仿真闭环通过
    - src/rtl/reset_sync.v: rst_n(低有效键)→异步置位/同步释放→rst(异步高有效)
    - src/rtl/soc_top.v: reset_sync + pipeline_top(SOC_BUILD=1) + uart_ctrl 装配
    （mmio 总线互联；imem 写口恒 0 固化模型；CLKS_PER_BIT 参数贯通）
    - test/tb_reset_sync.v: 异步置位/两级同步释放
    - test/tb_soc_full.v: 系统级 TB——CPU 轮询 TX_BUSY 发 A、等 RX_VALID、
    读 RX、回显；复用 uart_rx 作串口监视器、uart_tx 作注入器（双向串口模型）
    断言: 首帧 0x41、注入 0x42 回显一致
    - console 程序机器码经 riscv-none-elf-as 生成(18条)
    - 回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
    [reset_sync.v, soc_top.v, tb_reset_sync.v, tb_soc_full.v]
2026-09-05 exp2: Vivado 工程生成 + soc_top 综合自检脚本
2026-09-06 ref/编码: 全仓 UTF-8 排查结论固化（乱码=GBK 显示假象）+ fix_encoding 校验工具; doc: 性能分析方案(perf_analysis, T32-T35/M4)
2026-09-06 T32/T33: tb_perf.v 5档性能TB + run_perf.ps1 实测全绿; 报告 doc/perf_report.md（表A/C/单周期基线）
2026-09-06 exp2: uart_ctrl TX_BUSY 含挂起(pend)语义修复——写接受仅限完全空闲，消除连续 putc 丢字窗口; 契约同步(isa v1.4/top_design v1.5/interface v1.1)
2026-09-06 exp2 U40/U31: console.S 固件(banner+回显, 51条冻结集) + build_fw.ps1(hex/vh/子集校验) + tb_soc_console 固件版系统TB 四阶段验收全绿
2026-09-06 exp2 U32前置+U41: board.xdc(T5/T4/N5/P15) + 综合/工程脚本集成固件ROM固化(IMEM_INIT_VH, 自检41s过) + machine_code.md 机器码说明
2026-09-06 docs: SUBMISSION.md 两门课提交物核对清单（9/18 截止，逐项映射仓库路径/状态）
2026-09-06 U32: 依手册(EES-338 v1.0)核定接口约束——T5=100MHz, T4/N5=CP2102(8N1), P15=FPGA_RESET(极性待首测); soc_top 增 RST_ACTIVE_LOW 参数作极性 fallback(默认不变, 回归8/8)
2026-09-06 U32: 本机 Vivado 器件加载空转限制实证并记录; 新增 board_runs.tcl 健康主机一键出 bit(工程/固件/XDC 就绪)
2026-09-06 U32: 异地下板方案 board_runbook.md + program_devices.tcl(烧录) + uart_check.ps1(终端自动取证)
2026-09-06 工程入口: exp1/exp2 Vivado 工程独立分目录(vivado/exp1, vivado/exp2 各自清理互不影响) + 双击入口 exp1_vivado.bat/exp2_vivado.bat(缺失自动重建) + 路径引用同步
2026-09-06 工程入口改版: xpr 回 vivado/ 根级(board.xpr/exp2.xpr 互不清理), exp2 入口移至 exp2/exp2_vivado.bat, exp1 入口保持根目录
2026-09-06 工程入口定稿: exp1 xpr=仓库根 board.xpr, exp2 xpr=exp2/exp2.xpr（各入各自代码目录, 产物就地且互不清理, gitignore 同步）
2026-09-06 工程目录定稿: exp1 xpr=仓库根 vivado/board.xpr, exp2 xpr=exp2/vivado/exp2.xpr（各自 vivado 子目录互不清理）
2026-09-07 U32 里程碑: 上板实测打通! 实物=XC7A100T(手册误标35T); 存储缩容参数化(下板512B/256B, 仿真4KB不变); 本机全流程出bit烧录, COM8 banner+回显 ALL PASS; 工程/回归全绿(20+8)
2026-09-07 demo: 简易 RV32I 汇编器 + 样例程序回归 + run_tb 看门狗超时
    - simple_asm.py: 零依赖简易汇编器(26 条冻结集+伪指令白名单), uv 运行,
    产出 objcopy -O verilog 兼容 demo_rom.hex, 本机无 GNU 工具链时的本地替代
    - demo.asm + tb_prog_demo.v: 13 指令演示程序(循环累加 5..1 存 dmem), 12/12 断言 PASS
    - run_tb.ps1: 逐例看门狗超时(-TimeoutSec 默认30s, 超时 kill+继续) + 实时耗时,
    .NET Process 异步读输出取可靠退出码; 全量 21/21 PASS (233s)
2026-09-07 docs: 上板口径全量同步——器件=XC7A100T(实测)、下板存储缩容 512B/256B 说明、本机限制已解除记录
2026-09-07 fix(copilot-review): srli/srai funct3=101 编码、run_tb 事件按 SubscriptionId 注销、demo 补移位覆盖
    - simple_asm: enc_shift 原写死 funct3=001, srli/srai 应为 101 → 产错机器码;
    现按指令传 f3(slli=001, srli/srai=101), 修复后实测 0x335293/0x40335293 与手算一致
    - run_tb: Register-ObjectEvent 返回的 Id 是 SubscriptionId, 原按 -SourceIdentifier 注销会泄漏事件订阅; 改 -SubscriptionId
    - demo.asm+tb_prog_demo: 补 slli/srli/srai 3 条指令与断言(t4=60/t5=30/t6=15), 移位编码进回归; TB chk_word 地址掩码 addr[11:0] 对齐其它 tb_prog_*
    - run_tb 头注用法示例对齐 README(powershell -File src/scripts/...)
    [demo.asm, tb_prog_demo.v]
2026-09-07 PR#2 review fixes: 删 Vivado 运行产物(webtalk/timing)并 gitignore; firmware/machine_code 栈口径改 sp=0x100(下板256B); build_fw 默认 PadBytes=512; exp1 synth_check 器件改 100T; const_define BYTES 注释锁定成对覆盖(xvlog 不递归展开宏)
    [const_define.v]
2026-09-07 fix(simple_asm): jal 单操作数默认写 ra(x1)；li 缺操作数给 AsmError 而非 IndexError
    - jal label == jal ra,label（对齐 GNU as / RV32I 伪指令惯例，原误作 x0=纯跳转）
    - wordsize() 对畸形 'li x1' 先校验操作数个数，避免首趟 IndexError（Copilot 第二轮评论）
2026-09-07 PR#2 review fix(2): build_fw 增加 -PadBytes 校验(4字节对齐且不小于固件长度)，防越界/截断 .vh
2026-09-07 PR#2 review fix(3): const_define 资源口径按 35T/100T 分列修正 + 注明 addr[11:0] 固定(参数化仅支持<=4KB 缩容)
    [const_define.v]
2026-09-07 ci: 添加 CodeRabbit 自动 review 配置（dev 全自动审查）
2026-09-07 PR#2 review fix(4): 器件标识格式统一为 Vivado 规范串 xc7a100tcsg324-1（5 份文档）
2026-09-07 perf(run_tb): 并行 worker 架构 + 自动满核并行度——全量 233s→20s
    - 根因: 每例需冷启动 xelab+xsim 进程(~5-7s)，仿真本体微秒级; IDE 快因引擎常驻。
    - 改为 -Jobs 个独立 worker(各自 scratch 目录编译/elaborate/仿真，无共享库竞争)，
    墙钟≈N例/Jobs × 单例; 整 worker 看门狗(单例预算×例数+余量) 超时 kill 续跑。
    - Jobs=0 默认自动 = min(#TB, 逻辑核数) 满核并行; 可 -Jobs N 覆盖(1=串行)。
    - 实测(本机24核): 串行 288s → Jobs8 43s → Jobs16 33s → 默认21 worker 20s，21/21 PASS
2026-09-07 fix(run_tb, CodeRabbit review): 单例失败不中断整 worker + watchdog 绝对截止时刻
    - worker bat: xelab/xsim 单例失败仅打标并 goto 下一例(继续处理子集其余)，编译失败仍整体退出;
    避免一个坏例拖死整个 worker 后续用例
    - watchdog: 启动时定每 worker 绝对 deadline，等待时取剩余时间(而非顺次累加漂移);
    slack 随 Jobs 缩放(90s×ceil(Jobs/8))，匹配满核并行下的编译开销
    - 全量 21/21 PASS (21s, 21 worker)
2026-09-07 fix(run_tb, CodeRabbit review): TimeoutSec 参数加 [ValidateRange(1,MAX)] 校验
2026-09-07 docs: 仓库智能体指南 AGENTS.md + CLAUDE.md（本机 NTFS 硬链接同源）
    - 两文件同内容: CLAUDE.md 硬链接自 AGENTS.md(Windows 免管理员, 规避 mklink 软链需 Developer Mode)
    - 内容: 先读文档约定/两课结构与单源文档表、环境与工具(uv+simple_asm 汇编、Vivado xsim)、
    并行 run_tb 测试口径(定向加速, 最终提交可全量)、CodeRabbit 自动化 PR 流程(gh 命令/轮次/合并)、
    本机坑(僵尸 Vivado 进程)、修复链接命令
2026-09-07 docs: AGENTS.md 改唯一权威正文 + CLAUDE.md 独立入口(强制先读 AGENTS.md)，弃 hardlink
    - 不再用 NTFS hardlink(过于 hacky); AGENTS.md 为单源, CLAUDE.md 只做指向入口并摘硬约束,
    避免双源失同步; §6 改为两文件职责约定(改动只维护 AGENTS.md)
    - CLAUDE.md: 开始任务前必读 AGENTS.md(结构/环境/测试/CodeRabbit 流程/本机坑)
2026-09-07 目录重构: exp2 SoC 相关代码/文档迁至 soc/ + 新增 uart_ip_top 模块及配套 tb/文档
    - exp2/{doc,rtl,test,xdc} 迁移到 soc/ 对应目录
    - 删除 exp2 下 scripts/ 大部分（保留 build_fw/create_vivado_proj/synth_check 上游修复版）、uart_ctrl、exp2_vivado.bat
    - 新增 uart_ip_top RTL/tb 与文档、soc/README.md
    - 同步更新 README/SUBMISSION 及各模块文档
    [board.xdc, dbus_decode.v, pipeline_top.v, reset_sync.v, soc_top.v, tb_dbus_decode.v, tb_pipe_soc.v, tb_reset_sync.v]
2026-09-07 重构uart ip核
2026-09-07 目录重构: 计组 src/doc/exp1_vivado.bat → pipeline/，exp2 → UART/（纯移动）
2026-09-07 docs/scripts: 路径引用随目录重构更新（pipeline/ 前缀、exp2→UART、工程目录 pipeline/vivado）
2026-09-07 docs(UART): 补两处路径引用（exp2/src= 与计组 src/rtl/ → pipeline/）
2026-09-07 重构项目结构
2026-09-08 fix(test): tb_prog_demo 任务端口 expect→expected（SV 关键字，Verilator 拒收）
    [tb_prog_demo.v]
2026-09-08 docs(SUBMISSION): 变更记录/源代码行口径同步（exp2/→UART/，补列保留构建脚本）
2026-09-09 docs: 新增设计报告内容新稿 UART/doc/report_design.md（按重构后单源修订，含新增 §5.8 与计组交叉章节）；SUBMISSION 报告/源代码行同步
2026-09-13 chore(uart): 波形证据与生成器入库 + .gitignore 本地归档规则
    - 波形资产入库：UART/doc/wave/{README.md, uart_frame_868.txt, uart_frame_868.vcd}；
    真实分频 868 下单帧实测（位宽 8680ns、帧长 86800ns、波特率误差 0.0064%），
    替代示波器作为时序证据；.gitignore 对全局 *.vcd 忽略规则加本目录例外。
    - 生成器迁入正式位置：build/ → UART/src/test/tb_wave_868.v、
    UART/src/scripts/{run_wave868.ps1, extract_frame_vcd.ps1}；脚本改为从自身位置反推仓库根，
    xsim 中间产物统一落 build/wave868/（不入库）。
    - tb_wave_868 补断言：W1/W2/W3 不符累加 err，末尾按仓库约定打印 ALL PAS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
2026-09-13 docs(agents): 恢复本地 AGENTS.md 并写入"远程操作须显式授权"政策
    - 恢复被迁移操作覆盖的本地 AGENTS.md（该文件已被 .gitignore 忽略、不再随仓库分发）。
    - §3 改名"GitHub 工作流（CodeRabbit review；远程操作须用户显式授权）"，
    新增硬约束段：未经用户显式要求禁止 push / gh pr create / gh pr merge，
    默认只在本地建分支与提交、完成后报告待办。
    - 步骤 2/3/5/6 与"经验/边界"同步改为需用户显式指令的措辞。
2026-09-13 feat(exp1): 关键仿真波形 4 项与回归/性能汇总素材
    - wave_pipe TB + run_wave/wave_png/report_png 脚本；脚本产物入 sim_shots/auto/，sim_shots/ 预留人工截图
    - fwd_priority 同址连写场景（独立，不入回归）；回归 21/21
    - sim_experiments.md 持久化实验说明（原 plan.md 正文）
    - 表 D（Fmax/资源）本机综合空转，留待综合侧
2026-09-13 test(exp1): 波形 TB 输出仿真时刻并归档人工截图
    - wave_pipe.v: 各标记输出 WAVE_TIME 绝对时刻；VCD 改用真实 $time
    - 归档 5 张 Vivado IDE 人工截图（sim_shots/）
    - 重生成 sim_shots/auto/ 产物
2026-09-13 fix(exp1): 波形/汇总脚本校验输入完整性（CodeRabbit #8）
    - run_wave.ps1: 渲染前校验 5 个波形标记均非 -1，缺失即失败
    - report_png.ps1: 回归逐例校验日志存在且 ALL PASS（否则 MISSING/FAIL）；性能校验 5 档齐全且 ident=1/allpass=True；任一失败则不保存汇总表
    - sim_experiments.md: 断言总数口径说明（本次 21 项 250；含性能 5 档 74 则 314）
2026-09-14 complete performance analysis and clean workspace
    [2026-09-14_perf_summary.csv]
2026-09-14 fix: address PR review findings
    [2026-09-14_perf_summary.csv]
2026-09-15 feat: add standalone experiment 1 board validation
2026-09-15 fix(ppt): address review findings
    - strip trailing page separator before writing speaker notes
    - keep wave CSV inputs under ppt/wave so make_waves.py needs no simulator
    - define F and note F = 1 in the CPI identity on the performance pages
    [wave_cover.csv, wave_hazard.csv, wave_marks.csv, wave_priority.csv]
2026-09-15 fix(exp1-board): address PR #11 review findings
    - exp1_board_demo: harden the on-board self-check from 2 milestones to per-item
    accumulation of 24 checks (ALU group, lui+srli, sw->lw round trip and both
    load-use consumers, loop counter/sum, three shifts, signed/unsigned compares),
    folding big immediates by shifts. Verified by an out-of-tree mutation test
    (build/tb_mut.v): 22/22 injected faults change the signature away from 0x0F,
    0 missed - so "a covered feature is broken but PASS still lights" cannot happen.
    - board_runbook: give the post-route resources of the SHA-identified bit
    (11,338 LUT / 3,808 FF), compare build A and build B, and record the rebuilt
    bit B in a new sectio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
    [board_exp1.xdc, exp1_board_demo.asm, tb_prog_board_demo.v]
2026-09-15 fix(exp1-board): harden the self-check against ALU-level faults (review round 2)
    Round-2 review findings (CodeRabbit 05:53Z):
    - exp1_board_demo: replace the OR-based mismatch accumulation with independent
    xor/sub comparison + sltu normalization + add accumulation, so a broken ALU_OR
    can no longer swallow every mismatch and light PASS. The sltu-produced values
    (x9/x26) additionally go through an OR path that does not use sltu, and the
    signature step now ANDs two independent mechanisms (the sltu/sub/xor chain and
    "srl x8, 15, count") - merging them with add, because merging with or let an
    ALU_OR fault zero the accumulated count.
    - Add an ALU-level fault-injection test (build/alu_f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
    [board_exp1.xdc, exp1_board_demo.asm, tb_prog_board_demo.v]
2026-09-15 docs(exp1-board): sync the filming script and asm header with build C
    Round-3 review findings (CodeRabbit 07:01Z):
    - board_runbook 6.2: shot 5 still claimed the signature only checks the two old
    milestones and that the single F proves forwarding / load-use / branch flush /
    shifts; restate it as the 22-item self-check (see 5.1). Shot 6 quoted build A's
    resources; use build C's 12,165 LUT / 3,838 FF and point at 10.4.
    - exp1_board_demo.asm file header: it still described OR-based accumulation;
    describe the implemented xor/sub comparison, sltu normalization and add
    accumulation, and warn against restoring "or" (ALU_OR fault -> false PASS).
    Comment-only change: the regenerated exp1_b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
2026-09-15 docs: complete experiment 2 board video plan
2026-09-15 chore(soc): script the SoC Vivado project entry and fix the device part number
    - Move UART/src/scripts/create_vivado_proj.tcl to soc/scripts/create_soc_proj.tcl and
    point its output at soc/vivado/soc.xpr (was UART/vivado/exp2.xpr); the firmware init
    image is now copied inside the project (soc/vivado/soc_build/imem_init.vh) instead of
    a shared scripts/out directory. Part, top, defines, include dirs, TBs and constraints
    are unchanged.
    - Fix the device part number in the SoC documents: the board is an xc7a100tcsg324-1
    (JTAG idcode measured). soc/doc/board_runbook.md section 1 and soc/doc/top_design.md
    named xc7a35tcsg324-1 / XC7A35T-1CSG324C, which yields a bitstream that cannot be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
    [board.xdc, const_define.v]
2026-09-15 feat(reset): debounce the reset-key release on both board tops
    Root cause of the "garbled prefix before the banner" seen after pressing RESET: a
    mechanical key chatters for 0.1-5 ms on release, while the firmware starts
    transmitting within ~1 us, so the core gets re-asserted/released inside that
    window. Each cut-off frame (uart_tx drives tx combinationally, so it returns to
    idle-high the instant reset asserts) plus the re-zeroed baud divider mis-frames
    the first bytes on the host side while the remaining bytes stay clean - exactly
    the observed "+m??ff? RV32I UART OK".
    - reset_sync (soc) and exp1_reset_sync: new STABLE_CYCLES parameter, default 0 =
    cycle-identical to the old behaviour (so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
    [exp1_board_top.v, exp1_reset_sync.v, reset_sync.v, soc_top.v, tb_reset_sync.v, tb_soc_console.v, tb_soc_full.v]
2026-09-15 chore(scripts): keep the demo/verification scripts in the repo with usage docs
    The scripts that the runbooks and the PR discussion already reference lived only in
    the gitignored build/ directory, so a reader could not reproduce them. Move them in:
    - soc/scripts/serial_console.ps1: minimal serial console for the experiment-2 video
    and terminal acceptance. It prints only what the FPGA sends (equivalent to "local
    echo off"), logs everything received, and has a -LocalEcho diagnostic switch that
    must stay off while recording. Default log goes to build/.
    - soc/scripts/run_soc_tb.ps1: runner for the soc/test + UART/src/test testbenches,
    which pipeline/src/scripts/run_tb.ps1 does not collec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
2026-09-15 fix(review): 复位释放移入同步域 + 脚本防死锁/退出码 + 文档口径统一
    PR #13 的 12 条 CodeRabbit 意见逐条处理：
    - reset_sync / exp1_reset_sync：异步级只剩 meta_q，去抖计数与释放链改为
    **纯同步**（不再把异步释放沿直接接进计数器复位脚，消除 recovery/removal
    可能"提前满足 stable_ok"、吃掉去抖时长的风险）；输出 = 异步置位 +
    同步释放。**释放时序逐拍不变**（STABLE_CYCLES=0 仍 2 拍；去抖 N 仍 N+STAGES-1 拍），
    原 tb_reset_sync 断言一行未改仍 PASS；TB 新增 STAGES=3（覆盖释放链 generate
    分支）与**亚周期毛刺**用例（低 4 ns 不占整拍：必须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
    [exp1_reset_sync.v, reset_sync.v, tb_mut.v, tb_mut_alu.v, tb_reset_sync.v]
2026-09-15 fix(review): 二轮 review 4 条——退出码判据前置 + 释放沿判据收紧 + 回归项数更正
    - run_trace_bd.ps1：**先判 `$proc.ExitCode` 再解析 trace**。原先只在 `$rows.Count -eq 0`
    时报错，xsim 失败前已经吐了 TRC 行时，会用半截 trace 算出"看着正常"的指标。
    - run_soc_tb.ps1：判据由"日志含 ALL PASS"改为 `ALL PASS 且无 FAIL 行 且 退出码 0`
    （batch 在 xvlog/xelab/xsim 失败时返回 2/3/4；若失败发生在 ALL PASS 之后，
    以前会被记成 PASS 且汇总退出码 0）。
    - tb_reset_sync.v：去抖释放判据收紧到**首个可释放沿**——`repeat(8)` 稳定后只等
    第 9 拍（B1/抖动后/最终稳定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
    [tb_reset_sync.v]
2026-09-15 fix(review): 三轮 review——TB 断言标签全部收进 32 字符（不再被 c() 截断）
    `soc/test/tb_reset_sync.v` 的 `c` 任务形参是 `input [255:0] name`（= 32 字符），
    新增的 "dbg released at 9th edge after glitch"（37 字符）会被静默截断。
    本轮把所有超过 32 字符的标签一起收短（含改动前就超长的 3 条），并加了一次
    "标签长度全量检查"：23 个标签 0 个溢出。
    - dbg after final 8 stable: still rst → dbg final-8-stable: still rst
    - dbg released only after final settle → dbg released after final settle
    - dbg glitch restarts debounce: still rst → dbg glitch: still rst (recount)
    - dbg released at 9th edge after gli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
    [tb_reset_sync.v]
2026-09-16 docs(exp2): 归档实验二四项仿真截图、波形配置与运行日志
    - soc/doc/sim_shots/exp2/：13 个 wcfg + 12 张人工截图 + 15 份日志/证据
    - .gitignore：对该目录的 *.wcfg、logs/*.log 开例外（*.wdb 仍忽略）
2026-09-16 refactor(docs): 实验一 sim_shots 归入 exp1/ 子目录并同步引用
    - pipeline/doc/sim_shots/{*.png,auto/} -> exp1/（与 soc/doc/sim_shots/exp2/ 对齐）
    - 同步 pipeline/doc/sim_experiments.md、tasks.md、sim_shots/README.md、
    SUBMISSION.md、ppt/slides.md 与 wave_png.ps1 / report_png.ps1 输出路径
2026-09-16 feat(exp2): 波形 TB 与聚焦重绘（第 3/4 项）
    - UART/src/test/wave/tb_ip_duplex.v：全双工同现 STAT=2'b11、忙写丢弃、putc 连发；
    逐跳变 CSV（含组合 tx_accept），16 条断言 ALL PASS
    - soc/test/wave/tb_wave_soc.v：CPB=4 复现 console 程序，逐拍 CSV（MMIO 总线/引脚/监视器），5 条断言 ALL PASS
    - UART/src/scripts/run_exp2_wave.ps1：一键编译+运行，CSV 落 ppt/wave/exp2/
    - ppt/make_waves_exp2.py：由 CSV 渲染 exp2-duplex.png / exp2-mmio.png；接入 ppt/build.ps1
    - 波形 TB 位于 test/wave/ 子目录，soc 回归 3/3、-All 9/9 不变
    [ip_duplex.csv, wave_soc.csv]
2026-09-16 docs(ppt): 实验二波形页、分工页与下板实拍接入
    - 帧格式与波特率 / 发送忙碌状态 / 统一编址 三页改 right-bottom，各配人工截图 + 聚焦重绘波形（exp2-duplex / exp2-mmio）
    - 分工页与封面组员（柯宁皓为组长，列首）；封面补日期 2026 年 9 月 18 日
    - 下板页补现场实拍图 ppt/assets/下板终端日志.jpg；outline.md 同步
    - 重建 pptx（36 页，无占位）
2026-09-16 docs(ppt): 分工页合并两实验表格并去除「交付」措辞
    - 两个实验的分工表放到同一页（实验一：处理器核心 / 实验二：UART 与 SoC）
    - 删除「交付物」「交付内容」等措辞，改为「负责内容」并合并说明
    - 三级工程结构页「交付边界」改为「层次边界」
    - outline.md 同步；重建 pptx（36 页）
2026-09-16 docs(ppt): 验证机制页说明 23 项回归测试并补充运行截图
    - 验证机制页新增一句：处理器核心回归测试共 23 项，一次运行全部通过
    - 同页补充两张回归测试终端截图（运行列表、PASS 23/23 汇总），布局改为 dual-bottom
    - 截图归档至 pipeline/doc/sim_shots/exp1/ 并更新 sim_shots README
    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
2026-09-16 chore(logs): 四份个人课程设计日志（两实验合一，模板格式）
    按 `ppt/slides.md` §分工 重做的 4 份个人日志，每人一份、实验一与实验二
    合并在同一张表里（不拆分），内容格式与字体对齐根目录 `日志模板.xlsx`：
    - 成员与分工：柯宁皓（组长：验证回归/性能分析/上板测试 + 两课演示视频录制）、
    陈霆钧（IF/ID 前端 + UART 收发引擎 + 中期与答辩 PPT）、伍奕涛（EX/MEM 执行与访存 +
    寄存器层/uart_ip_top + 实验一报告文档）、陈乔（WB/冒险/顶层装配 + console 固件与固化 +
    实验二报告文档）。
    - 格式：一行一条工作内容，按天编号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
    [日志_伍奕涛.xlsx, 日志_柯宁皓.xlsx, 日志_陈乔.xlsx, 日志_陈霆钧.xlsx]
2026-09-17 docs(ppt): 备注写入讲者分工、尾页改致谢、统一同页多表列宽
    - 每页备注末尾加「主讲：X。」；分工页备注汇总讲者分工，outline.md 补讲者分工表
    - 尾页去掉设计要点列表，标题改「致谢」，版式改为整页深蓝底 + 居中大字号
    - build_ppt.py 新增 shared_table_widths()，同一页多张表共用一套列宽（分工页两表对齐）
    - 五级运行总览页标题改为「五级流水线运行总览」，正文「可用于核对」改为「展示了」
2026-09-17 feat(synth): 固定实现策略 Performance_Explore + AggressiveExplore phys_opt（构建 D）
    两个建工程脚本显式写入实现策略，避免 GUI 重建工程时退回默认 phys_opt 配置：
    - pipeline/src/scripts/create_exp1_board_proj.tcl（实验一板级工程）
    - soc/scripts/create_soc_proj.tcl（实验二 SoC 工程）
    STRATEGY = Performance_Explore
    PHYS_OPT_DESIGN = AggressiveExplore
    POST_ROUTE_PHYS_OPT_DESIGN = AggressiveExplore
    并在 board_runbook.md 记录由此得到的构建 D（同一 RTL/固件/缩容口径）：
    - 资源（post-route）：12,171 LUT（19.20%）/ 3,864 FF（3.05%）/ 0 BRAM / 34 IOB
    - 时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
2026-09-17 docs(perf): 2026-09-17 性能复测与下板口径时序资源证据（报告 v2.2）
    结构层（`run_perf.ps1` 重跑，2026-09-17）：
    - 8/8 档通过；每档恒等式 A/B=1、residual=0；5 个主档功能门禁 full_pass，
    3 个规模档按既有口径排除完整功能证据
    - 新生成 CSV 与 2026-09-14 版**逐行完全一致**（本轮优化只改实现策略、未改 RTL
    ⇒ 结构层 CPI/IPC/MIPS/CPU time 不变），归档为
    `pipeline/doc/perf_data/2026-09-17_perf_summary.csv`
    - 同日重跑 `run_tb.ps1` 23/23 PASS（24 s）作为功能回归门禁
    时序资源层（新增 §4.1「下板构建口径」）：
    - 同一 RTL/固件、存储缩容 512 B/256 B、策略 Pe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
    [2026-09-17_perf_summary.csv]
2026-09-17 docs(perf): 限定 C→D 的 WNS 改善为"跨 RTL 版本"的观测结果（review 意见）
    CodeRabbit 指出：构建 C 与构建 D 的 WNS 对比（−1.430 → −1.347 ns）跨了 RTL 版本
    （C 为去抖前 RTL，D 含复位释放去抖），不能单独归因于 `Performance_Explore` /
    `AggressiveExplore`。该意见成立，本次按最小改动补齐限定，不改变任何数字：
    - `pipeline/doc/perf_data/2026-09-17_buildD_postroute.md`
    - 构建条件表新增一行"与构建 C 的可比性"，说明 C→D 差是跨 RTL 的观测结果；
    - 结论 1 拆为"实测值 + ⚠️ 归因限定"，并指出**只体现物理优化增益的是同一构建内的
    routed（−1.646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
